kristianhentschel/REDEUCE/hardware/prototype/trivial-double/Readme.md

# Components placement

Switch and LED 'front', connected on back copper layer.

Resistor and Connector 'back', connected on front copper layer (one resistor leg on back copper).

# Design Rules

- Minimum Hole diameter 1.0 (default)
- Via Dia 1.5 - Via Drill 1.0
- Minimum track width 0.5
- Clearance 0.4

## Previous version, as produced 
- Minimum Hole diameter 0.3 (default)
- Via Dia 0.6 - Via Drill 0.3
- Minimum track width 0.4
- Clearance 0.4
