kristianhentschel/REDEUCE/PotentialExhibitionDisplay.odt

Glasgow University REDEUCE

# Significance of the DEUCE

In the mid 1950s, the company English Electric introduced the DEUCE computer, a commercially available version of the Pilot ACE, which was based on Alan Turing's original Automatic Computing Engine. Between 1955 and 1964, 31 DEUCE machines were sold around the world. Mostly used by Universities in the UK, the DEUCE was one of the first big steps towards the use of high speed computing in research.

Alan Turing's vision had a great emphasis on the speed at which calculations could be done. Due to the DEUCE being modelled after Turing's original ideas, the DEUCE ran programs in a way that made it the fastest commercial computer available for many decades after it was first released.

# History of the DEUCE at the University of Glasgow

The English Electric DEUCE was the University of Glasgow's very first computer, installed in the Chemistry building in 1959, on the condition that other universities and industries would be allowed to use it for research purposes as well. For the new few years, Universities all over Scotland, mainly Chemistry departments, would use the DEUCE to cut down significantly on time spent on calculations, increasing the overall productivity of research by impressive margins. The University's DEUCE was eventually replaced by the KDF-9, installed in March 1964.

# How Our Model Compares

### Display

The original DEUCE had 2 CRT displays, one displaying the contents of a selected Delay Line, the other display the contents of the Single, Quadruple, and Double Register stores.

Our model has the same arrangement for the display, but doesn't use CRT tubes, instead just opting for a (tablet?) with the memory contents displayed in a similar fashion to the original.

### Materials

The DEUCE's memory was made of Mercury Delay Lines, and a large magnetic store drum to hold extra words.

Our model instead just emulates memory and the processor through a Raspberry Pi, encased inside of our Console and displaying the outputs on the Console lights as well as the Display screen.

### Functionality

The REDEUCE, as it is now, does not have some of the functionality of the original machine. Storage in the Magnetic Drum has no corresponding emulation, and some functions such as the Multiplier/Divider units were not implemented during the project. The REDEUCE can, and does, read in programs written in (historically accurate?) DEUCE machine language, given that the program uses mostly basic arithmetic and memory transfers.

# Interacting With the Model

The REDEUCE works by getting an example program read into the machine, pressing the “Initial Input” key so the program gets stored into memory, and then the program can be stepped through at the control of the user by using the console. As the program progresses, the user should be able to see changes happening on the display. The User can also set up “Request Stops” by setting the NIS, Source, and Destination words on the Console, so that the program stops when certain instructions are reached.

# Read More

More about the DEUCE, including manuals for both the use of and programming for the machine can be found here:

http://users.tpg.com.au/eedeuce/
