kristianhentschel/REDEUCE/ProjectStatus.odt

Glasgow University Internship Project: REDEUCE

# Model Requirements:

- Ability to read in a file of a correctly written DEUCE program, and execute said program based on user inputs

- User should be able to manipulate states in the machine, such as if it should stop during certain instructions via REQUEST_STOP functionality

- User should be able to step through a program manually, seeing the changing states along the way

- User should also be able to step through a large portion of a program at once

More complex interactions with the above are unlikely, as the learning curve with the system is very steep. Writing ones own programs, or very intricate running of programs which take in multiple sets of cards, is only possible with quite a lot of experience with the machine.

Because of this steep learning curve, combined with the fact that there was very little true interaction even with the original machine, the variety in interaction with our model of the machine is quite small. However, making it much more versatile would be staying less true to the actual machine.

# Current State of Emulator:

- Currently a large Java-based Emulator which provides a text-based IO which can write to files and step through programs according to user input.

- On top of this, there is also a Parser which should be able to receive input and send output in a way that a simple interface ought to be able to manipulate. The outputs could be translated into signals which manipulate the state of lights, for example. And inputs to the parser could be written with fairly simple translations.

- squaresProgram.txt is a historically-correctly written program which prints out perfect squares, such as 1,4,9,16,etc until the maximum value that can be represented in a 32-bit word. The emulator executes this program perfectly, as can be seen via the Console class, given the correct inputs.

- Highly Object Oriented! Only very large classes are the Processor and the Parser, as they have a lot of logic involved in their usage.

- Basic STOPs and the like are implemented with the User Interface. Given the right state, a user ought to be able to “catch” the program during certain instructions and so on.

# Shortcomings of Current Emulator:

- Only uses the “high speed store,” not implementing any of the functionality of the magnetic drum for extra storage.

- Currently throws an error every time every “card” in a program has been read into the machine. It does not impact execution of the program, and should be able to be worked around fairly easily. Due to time constraints however, I was hesitant to refactor all of the necessary code and leave the project non-functional.

- Has NOT implemented the Multiplier/Divider units of the original machine. It was agreed upon members working on the project that much more basic programs should be prioritised for the purposes of this project.

- Has not implemented the TCA/TCB states of the machine which are meant to manipulate how words are read in and manipulated when their respective states are active. Again, due to time-constraints and a potential misunderstanding of their functionality, which made the prospect of implementation very risky.

- As it is now, it might be that manipulating the switches on the console is not possible while it is executing a program, which was presumably possible on the original machine. More threads might make this possible, but that level of refactoring was not possible given the time left in the project when this was considered. Potentially doesn't affect our original intention on how a user would interact with the device in any case, however.

- Due to uncertainty in understanding of program's execution on the machine, programs which take in large amounts of data, or read in data multiple times, were not considered in this emulator's implementation.

# Recommended Reading:

- http://users.tpg.com.au/eedeuce/ldmpart1.html#index

- http://users.tpg.com.au/eedeuce/pm.htm#ch5

- http://members.iinet.net.au/~dgreen/deuce/mud21.html

- http://members.iinet.net.au/~dgreen/deuce/extract.html#mud19

- http://www.fcet.staffs.ac.uk/jdw1/sucfm/eedeuce/pjwalker.htm

These, along with a trip to the University Archives, made up a majority of the reading done in preparation for the emulation of the machine. Other sources were read and other people consulted for advice on what makes a good technology exhibit, etc.

# Advice for DEUCE Programming:

- Instructions are stored in Delay Lines, so as you are writing your program, make sure you're keeping track of which microcycle you would be in at the time of that line's execution. If you find yourself looping past 32, make sure you're either intentionally forming a loop, or make sure the instructions get written into a new Delay Line AND that the NIS for the last instruction leads to this new delay line.

- Most instructions will take 2 microcycles. So for very basic programs, it is probably best to just have every other line be an empty line. Also gives space if you want to exit a loop, as loops are exited by a DISCRIM instruction adding an extra microcycle before fetching the next instruction.

- Most easily written in a “higher level” form, such as “27-13” rather than a long string of 1s and 0s.

- Remember DEUCE words were represented in “backwards” binary!

- Keep a list of the different types of instructions nearby, some are very unintuitive.

- Re-read the recommended reading. Multiple times.

- First 4 lines of each Triad should be the same other than the Delay Line which they're instructing the machine the write the Words to.

# Future Development:

- Errors need refactoring

- Number of outputs probably needs changing depending on loops. Perhaps when there's a loop, such as when a user wants a program to run on its own, the number of outputs should be contiually added inside of the loop itself so if there is a STOP (such as when the STOPKEY is UP), then there aren't extra outputs waiting in the pipeline to be outputted.

- Potential multi-threading for different potential user inputs while execution is being carried out; assuring the appropriate responses are given at appropriate times.

- Multiple User Interfaces. Web-based app? Hardware Implementation?

- Multiply/Divide units should be implemented

- Multiple subroutines should be written, along with more example programs

- Implement behaviour of different states. TCA/TCB, forced DISCRIM, etc.

- Make sure messages sent from the Parser are received and manipulated as they should be. Strings split and converted into a DL display, for example.

# Running the Emulator:

To run the squaresProgram.txt file, one must just:

- Run the ParsedConsole class' main method

- Input “LOAD_CARDS squaresProgram.txt”

- Input “INIT_IN”

- Input “ONE_SHOT_UP”, or “ONE_SHOT_DOWN”, or “ONE_SHOT_DIAL (1-10)”, or “RUN”

- There should be outputs from here.

- “START_PUNCH” opens a file called cardsPunched.txt, which gets values written into it each time a punch instruction is executed.

- “CLEAR STORE” erases everything in memory.

- “OFF” turns off the machine.

- “EXTTREE (setting)” changes the setting to, for example, REQUEST_STOP.

Other commands can be executed, but the above is a very basic example of our intended interactivity.
