kristianhentschel/REDEUCE/hardware/plans/deuce-parts-costs.xlsx

Date | Supplier | Description | Total inc. VAT and Shipping
2016-07-25 | DigiKey | Prototype Components | 68.64
2016-07-29 | Rapid | PCB milling copper clad boards | 22.55
2016-08-11 | Flux Laser Studio | Laser Cutting inc. Materials | 51.6
2016-08-26 | Manchester Uni Library | Deuce control panel document scans | 36
2016-08-12 | DigiKey | switches and other components | 244.14
2016-08-12 | RS | cables and other components | 31.67
2016-08-12 | CoolComponents | printer | 56.67
2016-08-12 | Amazon | pi, power supplies, hardware, screen | 102.45
2016-08-19 | Ragworm/Stickleback | PCB production | 247.97
