kristianhentschel/REDEUCE/hardware/plans/v1_bom.xlsx

Sheet: Sheet1
Quantity | Part | Supplier | Supplier Part Number | Unit Price ex VAT | Unit Price inc VAT | Previously bought | Comment | Extended Price inc VAT | Still to order
1 | Raspberry Pi 3 | amazon | http://www.amazon.co.uk/dp/B01CCOXV34 |  | 30.7 | 0 |  | 30.7 | 1
1 | Aukru Micro USB Power Supply 5V 2000mA | amazon | https://www.amazon.co.uk/Aukru-Supply-Charger-Raspberry-Banana/dp/B017YW26YE |  | 4.99 | 0 | 2A Power supply for raspberry pi | 4.99 | 1
1 | waveshare 7 inch LCD(C) 1024x600 Rev 2.1 | amazon | https://www.amazon.co.uk/Waveshare-Capacitive-Interface-Raspberry-Beaglebone/dp/B015E8EDYQ |  | 45.99 | 0 | 7 inch HDMI display with mounting holes, could alternatively get a full size mnonitor | 45.99 | 1
1 | SanDisk Extreme 16 GB microSDHC Class 10 | amazon | https://www.amazon.co.uk/SanDisk-Extreme-microSDHC-Frustration-Packaging/dp/B013P1M49A |  | 10.47 | 0 | sd card for raspberry pi | 10.47 | 1
1 | M3 x 20mm bolts | amazon | http://www.amazon.co.uk/dp/B015A38FUS |  | 7.07 | 0 |  | 7.07 | 1
1 | M3 hex nuts | amazon | http://www.amazon.co.uk/dp/B00GYS1SXU |  | 3.23 | 0 |  | 3.23 | 1
1 | Thermal printer | coolcomponents | 695 | 37.92 | 45.504 | 0 | card punch! | 45.504 | 1
2 | Thermal printer paper 34ft | coolcomponents | 696 | 1.63 | 1.956 | 0 |  | 3.912 | 2
40 | SWITCH TOGGLE SPDT 5A 120V | DIGIKEY | EG2352-ND | 1.514 | 1.8168 | 1 | on-off | 72.672 | 39
50 | SWITCH TOGGLE SPDT 5A 120V | DIGIKEY | EG2389-ND | 1.764 | 2.1168 | 1 | mom-off-mom | 105.84 | 49
5 | SWITCH TOGGLE SPDT 5A 120V | DIGIKEY | EG2394-ND | 2.14 | 2.568 | 4 | mom-off-on | 12.84 | 1
0 | SWITCH TOGGLE SPDT 5A 120V | DIGIKEY | EG2377-ND | 1.62 | 1.944 | 4 | on-off-on | 0 | 0
12 | IO EXPANDER I2C 16B 28SDIP | DIGIKEY | MCP23017-E/SP-ND | 0.9 | 1.08 | 2 | one per 8 double/16 single switches | 12.96 | 10
2 | IC DRVR DSPLAY LED 8DIG 24-DIP | DIGIKEY | MAX7221CNG+-ND | 6.35 | 7.62 | 2 |  | 15.24 | 0
0 | LED AMBER DIFF 5MM OVAL T/H | DIGIKEY | 1125-1192-ND | 0.2092 | 0.25104 | 100 |  | 0 | 0
2 | CONN IC DIP SOCKET 24POS TIN | DIGIKEY | ED3049-5-ND | 0.19 | 0.228 | 2 |  | 0.456 | 0
12 | CONN IC DIP SOCKET 28POS TIN | DIGIKEY | ED3050-5-ND | 0.235 | 0.282 | 2 |  | 3.384 | 10
0 | AC/DC WALL MOUNT ADAPTER 5V 5W | DIGIKEY | 1470-2764-ND | 4.71 | 5.652 | 1 | Output: 5V 1A, for lights | 0 | 0
2 | CON PWR JCK 2.0 X 6.0MM HIGH CUR | DIGIKEY | CP-050AH-ND | 0.77 | 0.924 | 1 |  | 1.848 | 1
20 | 4POS SIL HORIZONTAL PIN HEADER | DIGIKEY | 952-1965-ND | 0.087 | 0.1044 | 0 | 12 * 4 pins angled, used on switch boards | 2.088 | 20
2 | CONN HEADER 48POS .100" SNGL TIN | DIGIKEY | SAM1035-48-ND | 1.7 | 2.04 | 0 | 12 * 4 pins, used on main board | 4.08 | 2
1 | AC/DC WALL MOUNT ADAPTER 5V 12W | DIGIKEY | 1470-3108-ND | 8.22 | 9.864 | 0 | 2.5A power supply for printer | 9.864 | 1
1 | SWITCH PUSH SPST-NO 3A 120V | DIGIKEY | EG1932-ND | 2.08 | 2.496 | 0 | mc slip button | 2.496 | 1
2 | LED RED DIFF 5MM ROUND T/H | DIGIKEY | 160-1964-ND | 0.31 | 0.372 | 0 | alarum | 0.744 | 2
12 | 4 pin 70cm dupont connector assembled jumper wires female-female | EBAY |  |  | 0.289 | 12 | 4 pin wires for switch rows (already bought by kristian as shipped from china, may take a while to arrive) | 3.468 | 0
1 | one-shot dial tbd | EBAY |  |  | 15 | 0 | old telephone dial | 15 | 1
1 | 3mm laserable plywood 600x600mm | flux laser studio glasgow | material | 5 | 6 | 0 | as per price list. 600x600 base is big enough for front panel and spacers. | 6 | 1
1 | front panel laser cutting service | flux laser studio glasgow | cutting time | 30 | 36 | 0 | £30 minimum charge | 36 | 1
1 | front panel laser cutting service | flux laser studio glasgow | delivery | 8 | 9.6 | 0 |  | 9.6 | 1
1 | main board pcb production 100x100 | ragworm |  |  | 40.3 | 0 | 100x100mm double sided PCB guide price | 40.3 | 1
0 | RVFM Copper Clad Double Sided FR4 Fibre Glass Board 203 X 305mm | RAPID | 34-0845 | 3.7 | 4.44 | 4 | PCB production base material | 0 | 0
16 | RS Pro Right Angle Cable Mount IDC Connector Socket, 10 Way, 2 Row, 2.54mm Pitch | RS | 625-7369 | 0.29 | 0.348 | 0 | 2x10 IDC cable end | 5.568 | 16
16 | Through Hole IDC Connector Plug, 10 Way, 2 Row, 2.54mm Pitch | RS | 625-7252 | 0.23 | 0.276 | 0 | 2x10 IDC pcb end | 4.416 | 16
1 | RS Pro 10 Way Unscreened Flat Ribbon Cable, 12.7 mm Width, 10m | RS | 214-0661 | 13.21 | 15.852 | 0 | 10m ribbon cable for LED connections and switches | 15.852 | 1
10 | 2n7000TA Fairchild (in pack of ten) | RS | 39-0224 | 0.14 | 0.168 | 0 | mosfet for max7221 logic level shifter | 1.68 | 10
1 | Rotary Switch, 16 Way, Through Hole | RS | 655-3235 | 3.46 | 4.152 | 0 | delay line select | 4.152 | 1
1 | Box / Rack for mounting front panel and main board in | TBD |  | 0 | 0 |  | build a wood frame? | 0 | 1

Sheet: Sheet2
Total Cost inc VAT
538.414
