kristianhentschel/REDEUCE/hardware/plans/deuce-interface-plan.pdf

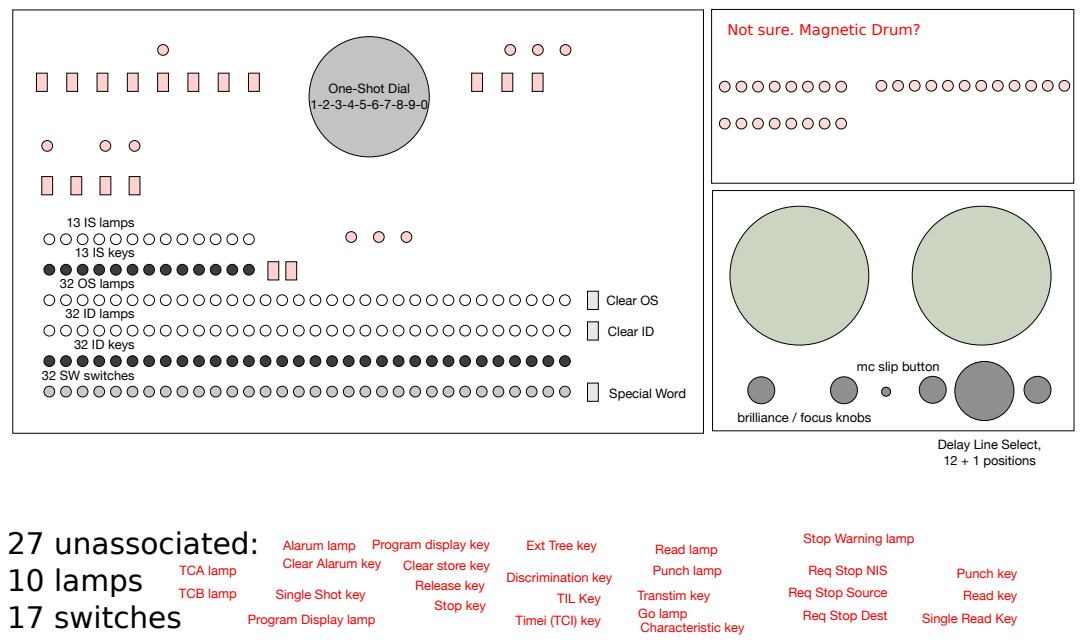
[picture p2: page 1]
13 IS lamps; 13 IS keys; 32 OS lamps; 32 ID lamps; 32 ID keys; 32 SW switches; Clear OS; Special Word; Clear ID; Discrimination key; Punch key; Characteristic key; Punch lamp; Read lamp; Go lamp; TCB lamp; TCA lamp; 27 unassociated: 10 lamps 17 switches

Not sure. Magnetic Drum?

One-Shot Dial

mc slip button

brilliance / focus knobs

Delay Line Select,
12 + 1 positions

Stop Warning lamp Alarum lamp
Clear Alarum key

Program display key
Clear store key
Transtim key Release key

Ext Tree key

Req Stop NIS
Req Stop Source
Req Stop Dest

Stop key Single Shot key
Program Display lamp

Read key
Single Read Key

TIL Key
Timei (TCI) key
