kristianhentschel/REDEUCE/hardware/plans/v1_board_assembly.pdf

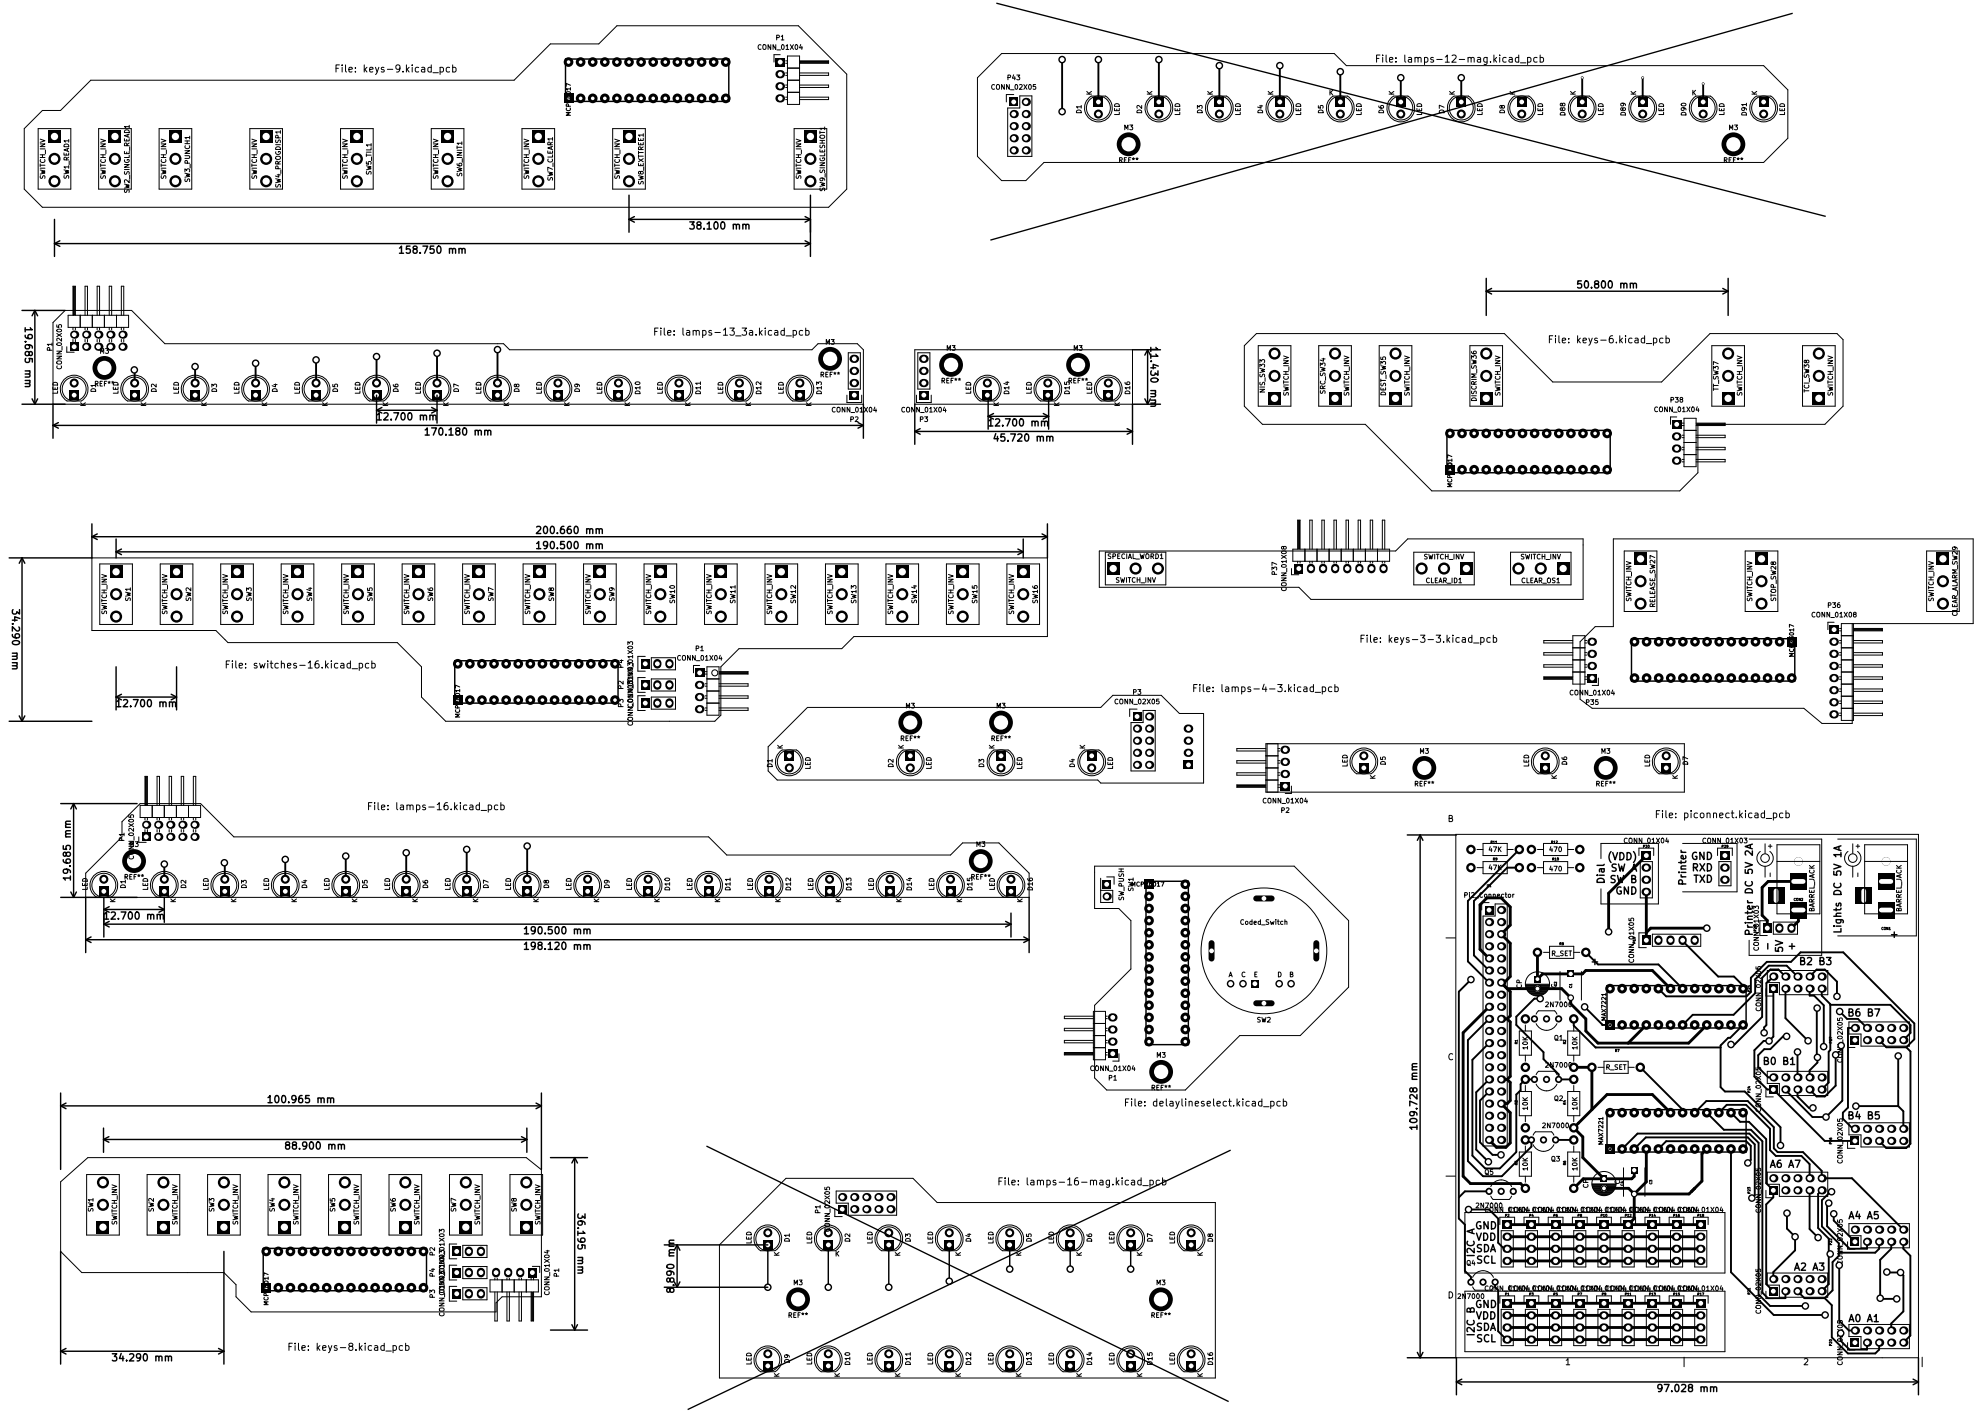
[picture p3: page 1]
