kristianhentschel/REDEUCE/hardware/v1/piconnect-brd.pdf

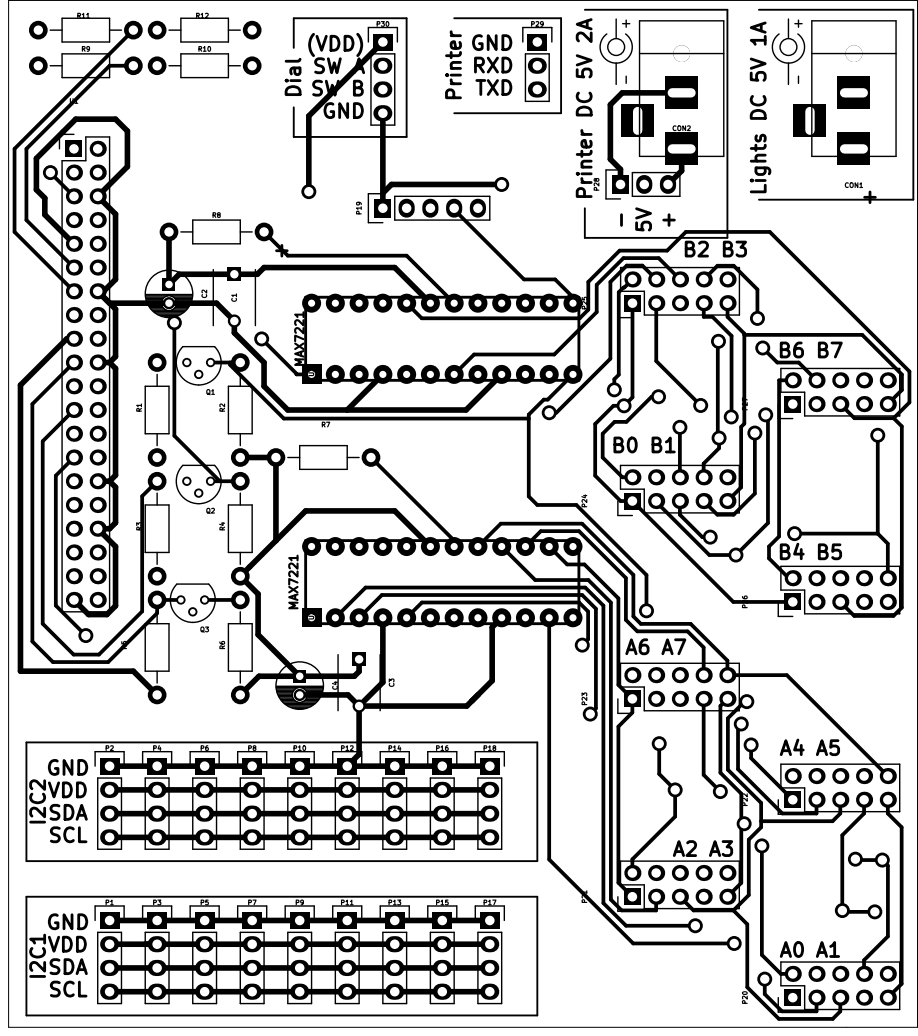
[picture p4: page 1]
