kristianhentschel/REDEUCE/hardware/plans/KristianHentschel_600x600mm_3mmPlywood_deucepanel_2016-08-11_2.pdf

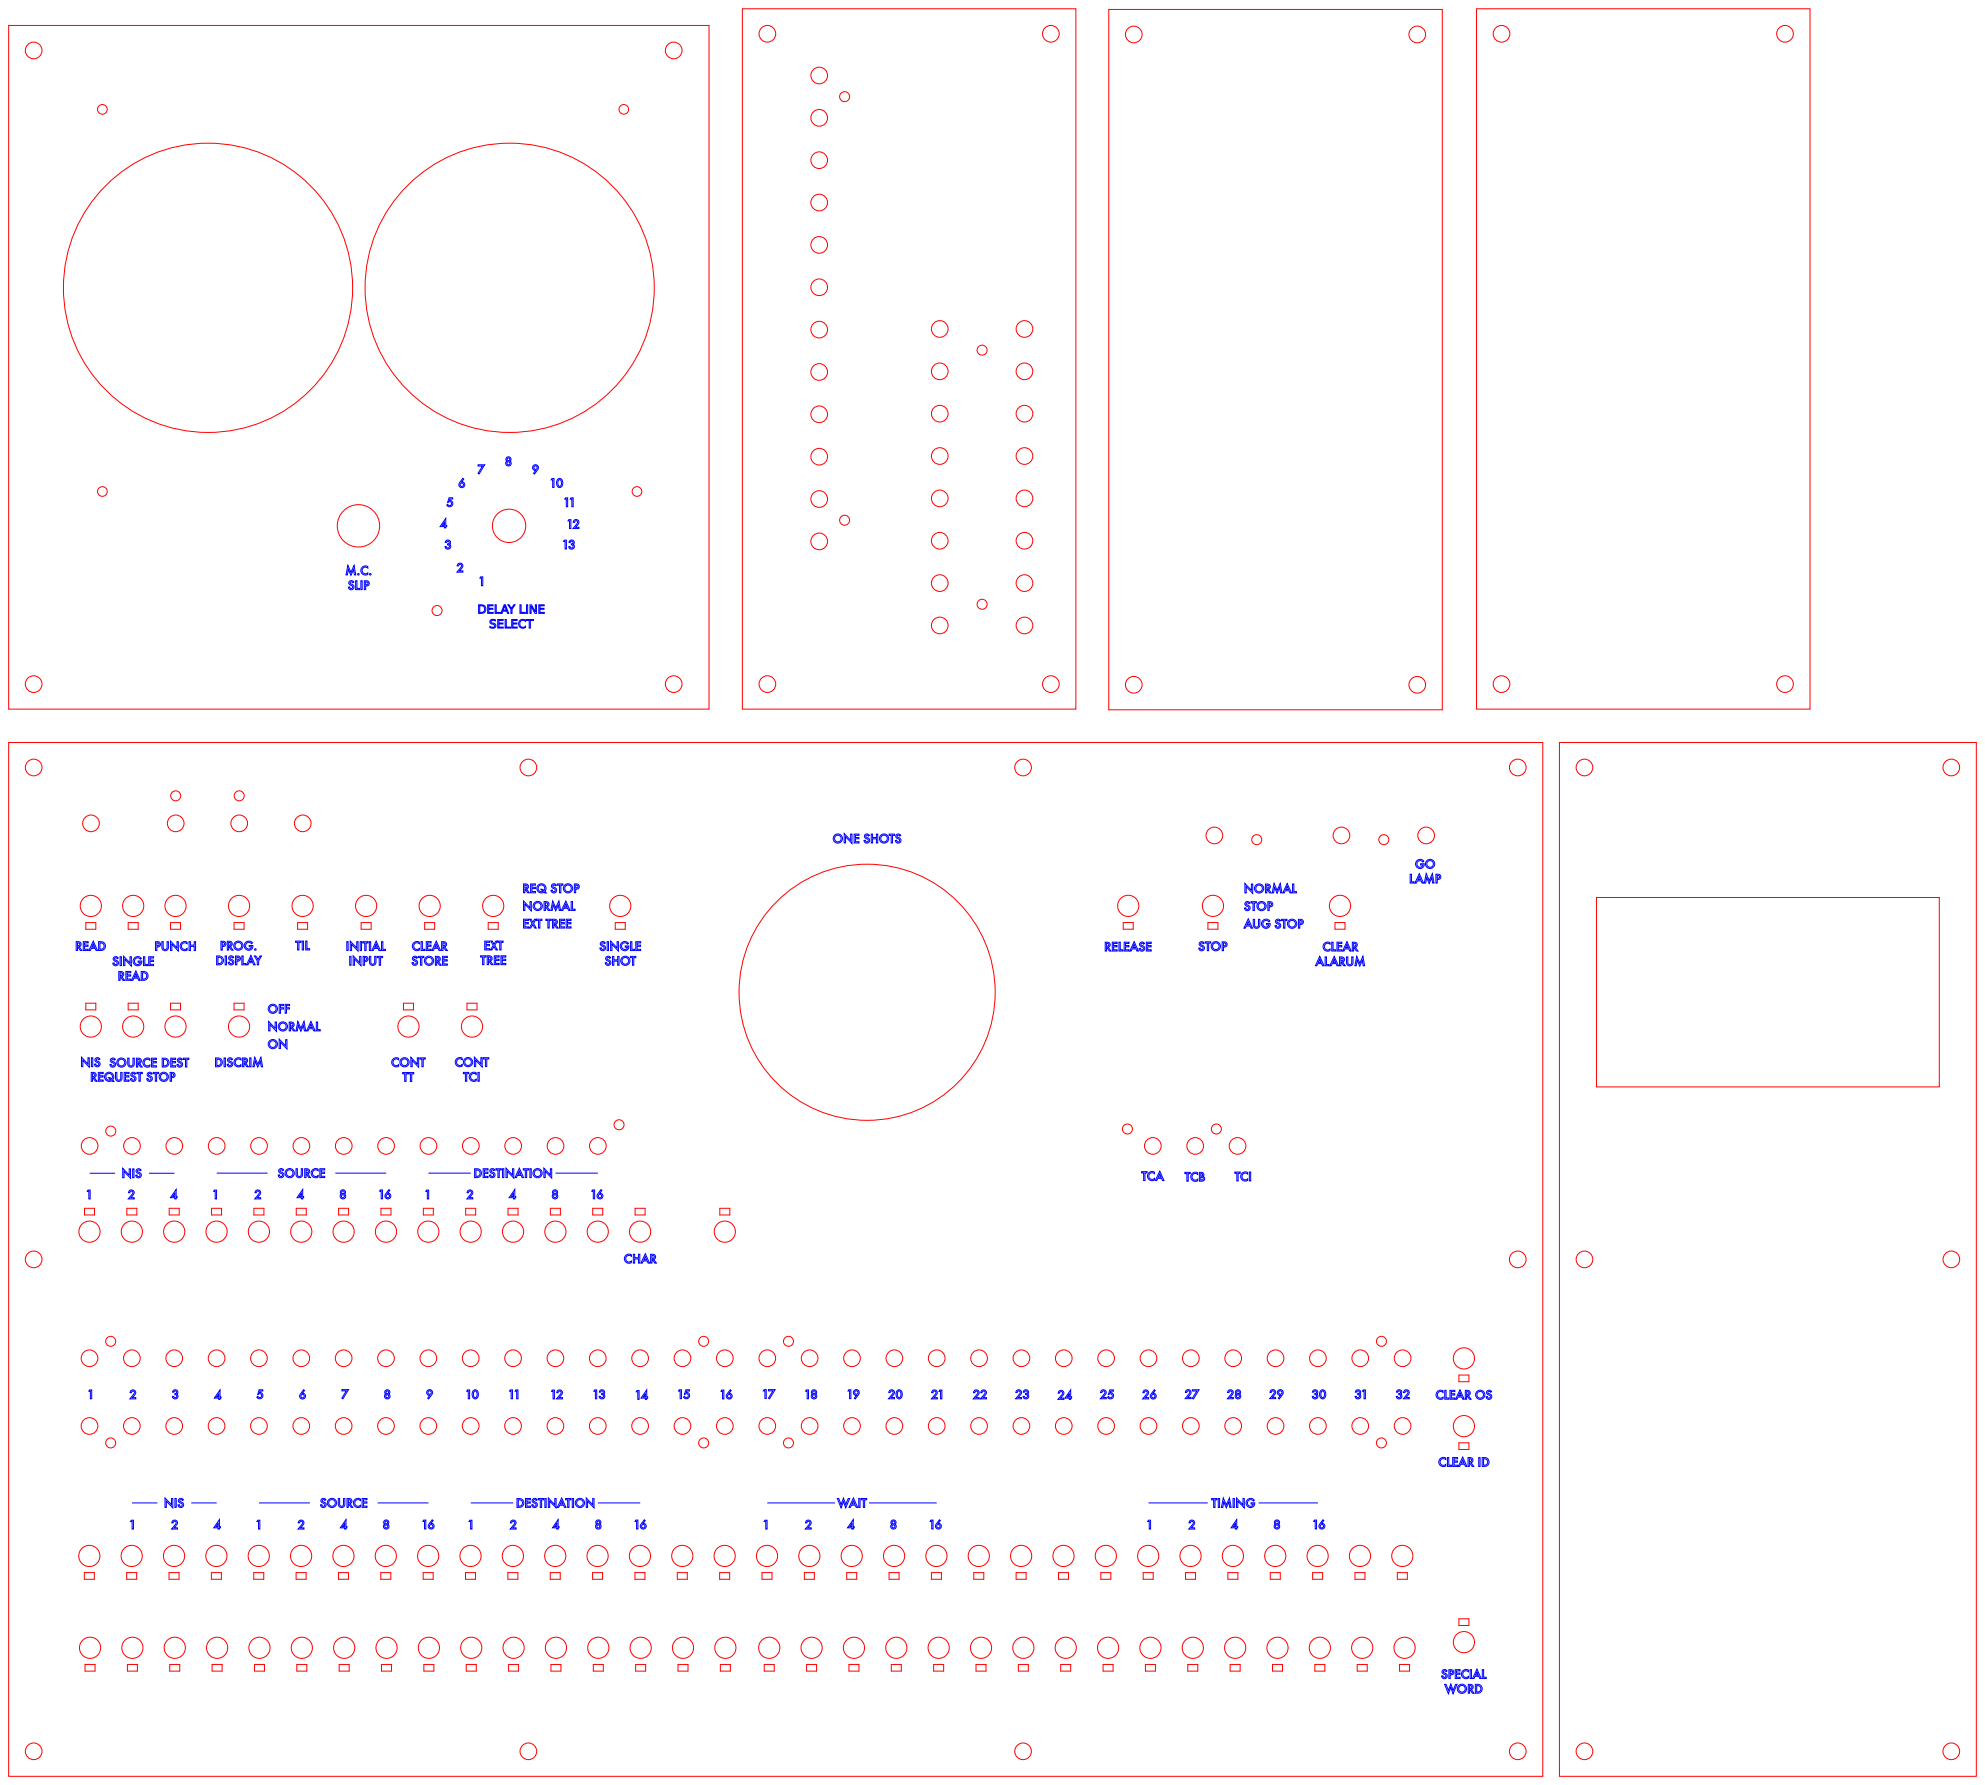
[picture p5: page 1]
