kristianhentschel/REDEUCE/hardware/plans/v1_frontpanel_cut_engrave.pdf

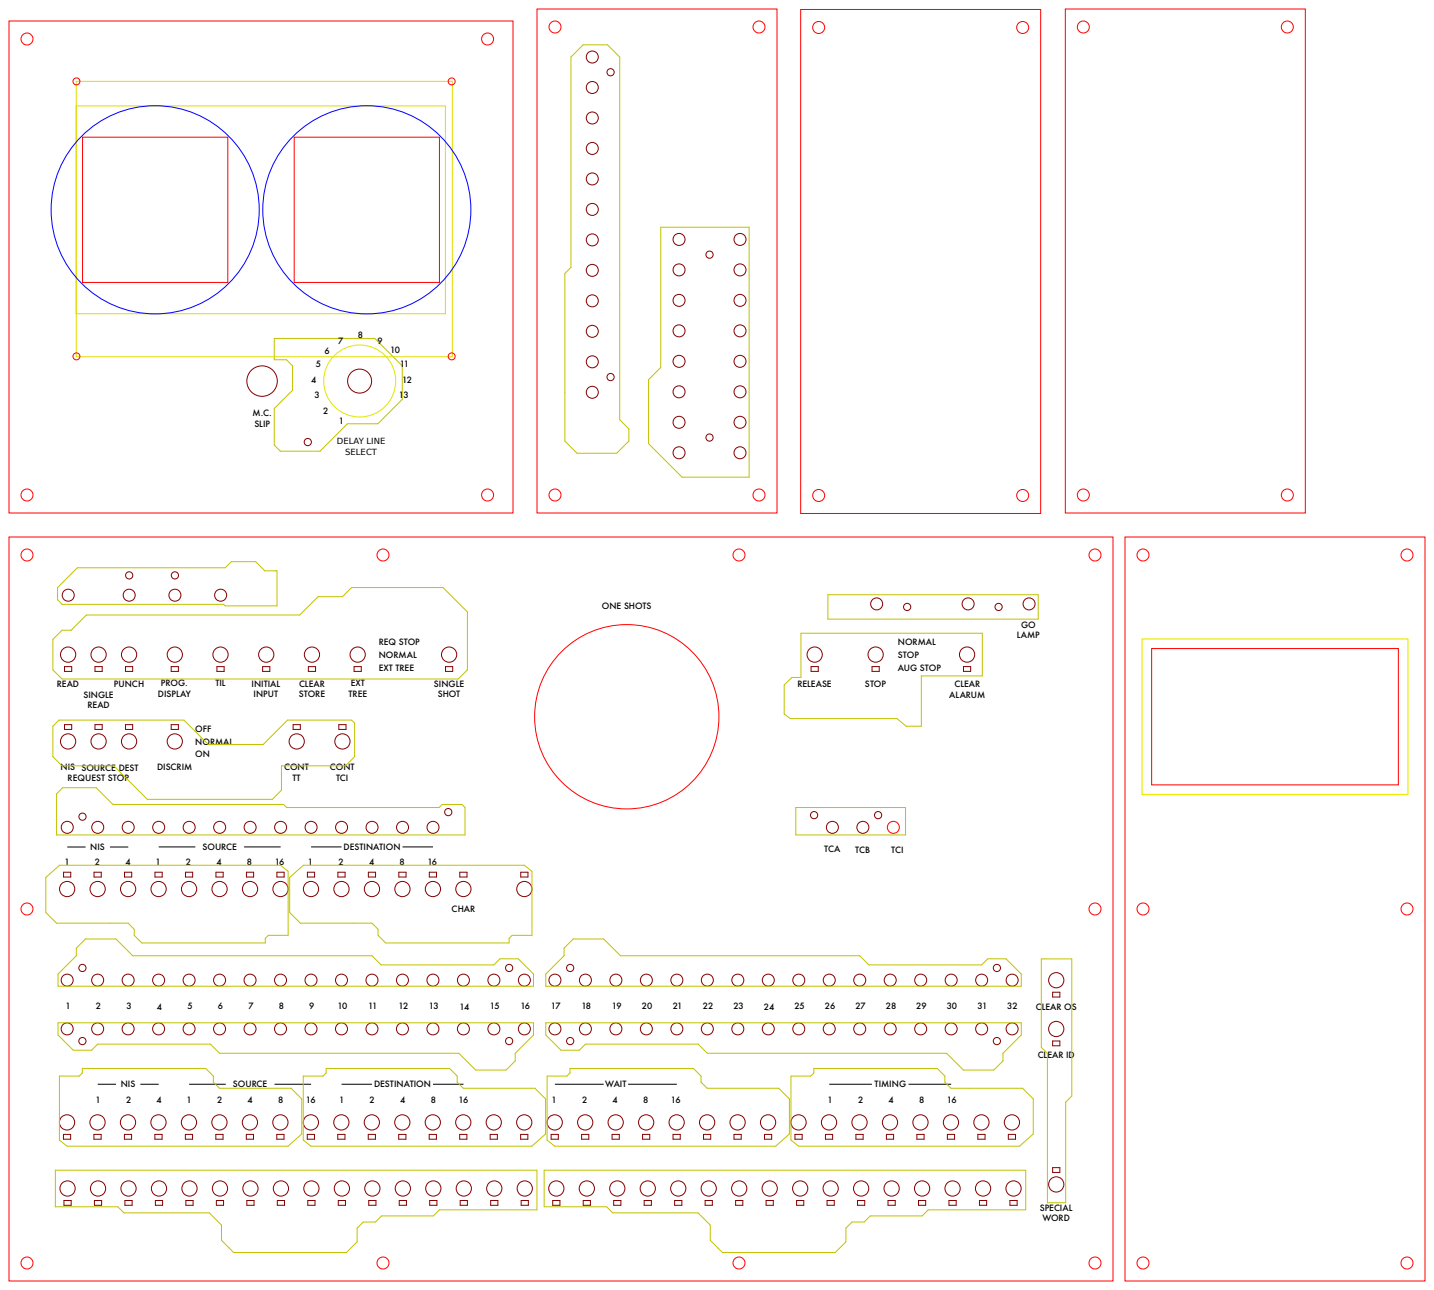
[picture p6: page 1]
M.C. SLIP; DELAY LINE SELECT; NIS; SOURCE; DESTINATION; WAIT; TIMING; CLEAR ALARUM; SPECIAL WORD; CLEAR ID; SINGLE SHOT; CLEAR OS; TIL; CLEAR; STORE; TCI; CONT TT; TCA; TCB; INITIAL INPUT; READ; PUNCH; ONE SHOTS; SINGLE READ; REQ STOP NORMAL EXT TREE; NORMAL STOP AUG STOP; OFF NORMAL ON; GO LAMP; RELEASE; CHAR; PROG. DISPLAY; STOP; DISCRIM; EXT TREE; CONT TCI

NIS SOURCE DEST
REQUEST STOP
