kristianhentschel/REDEUCE/hardware/docs/pushbutton-F030015.pdf

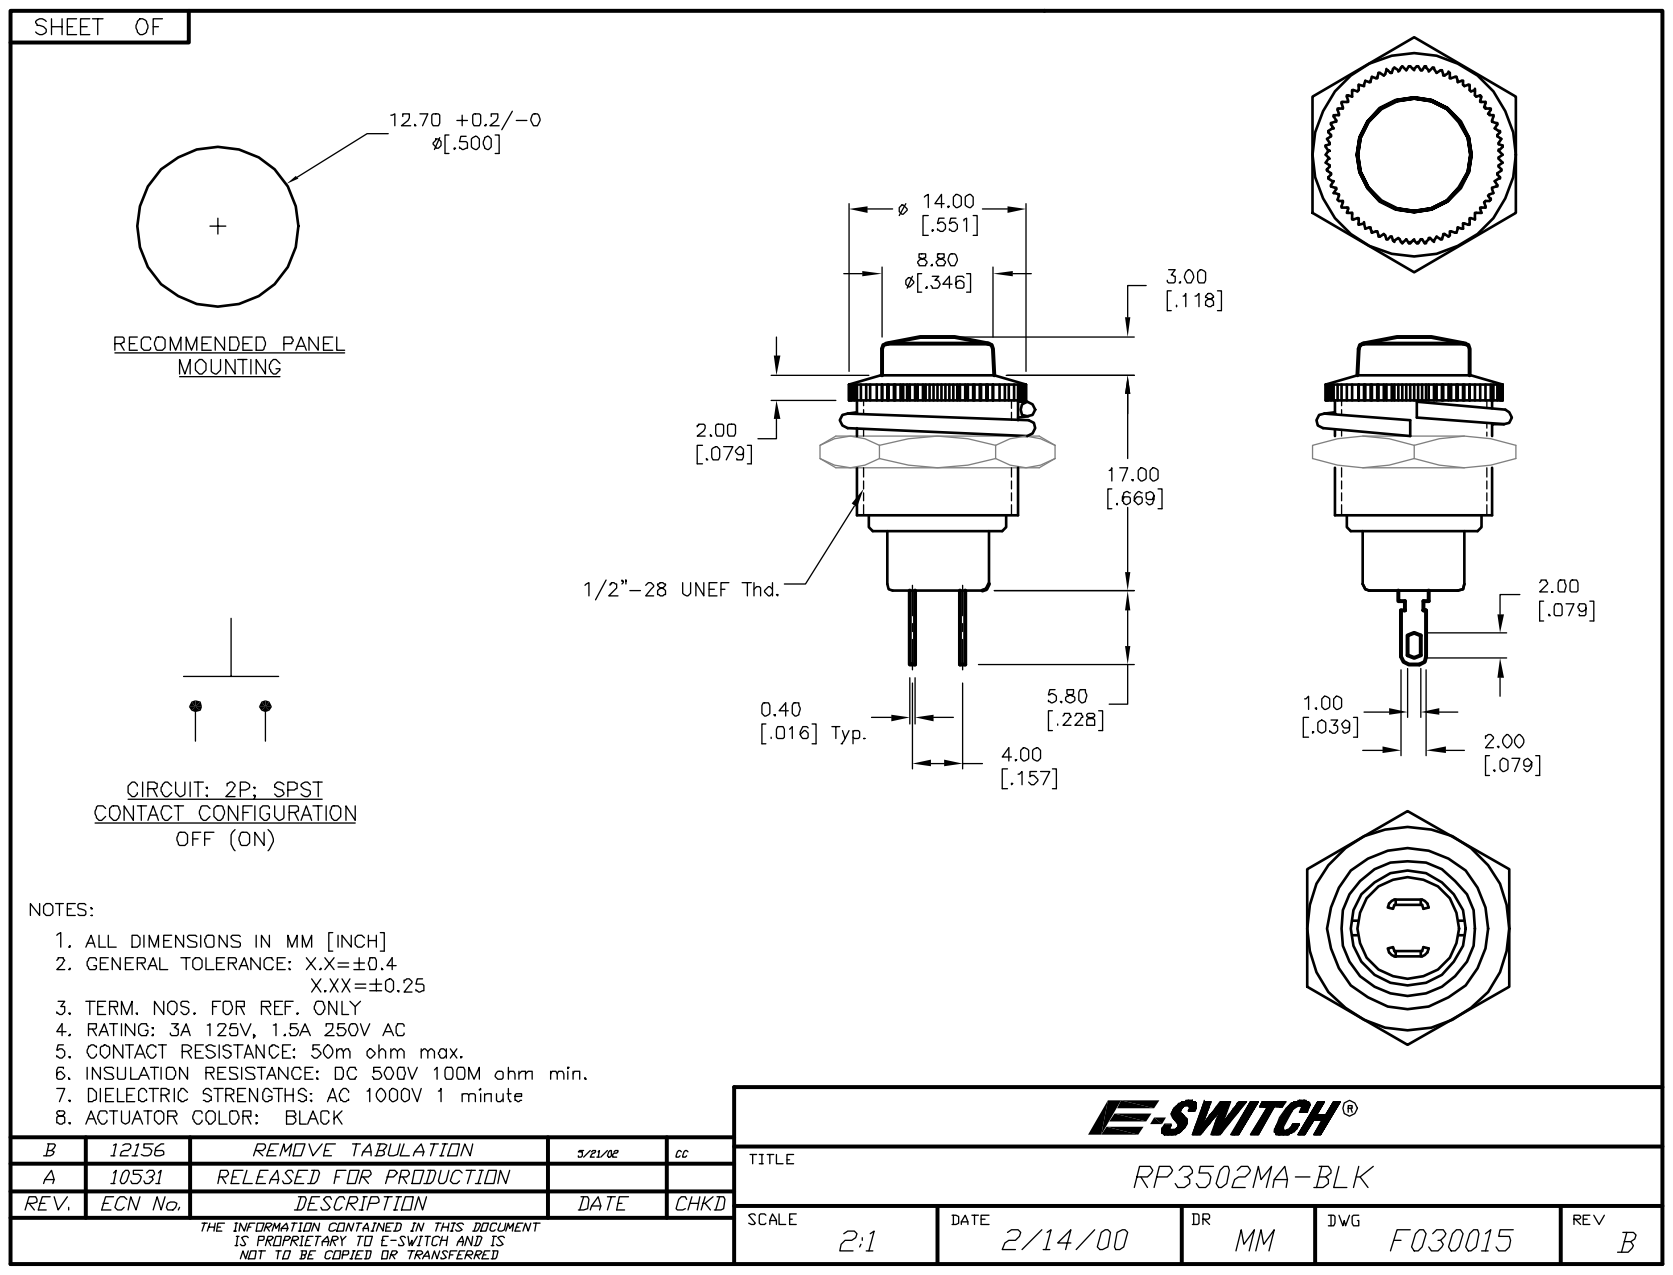
[picture p7: page 1]
