kristianhentschel/REDEUCE/hardware/docs/toggle-switch-ST115003.pdf

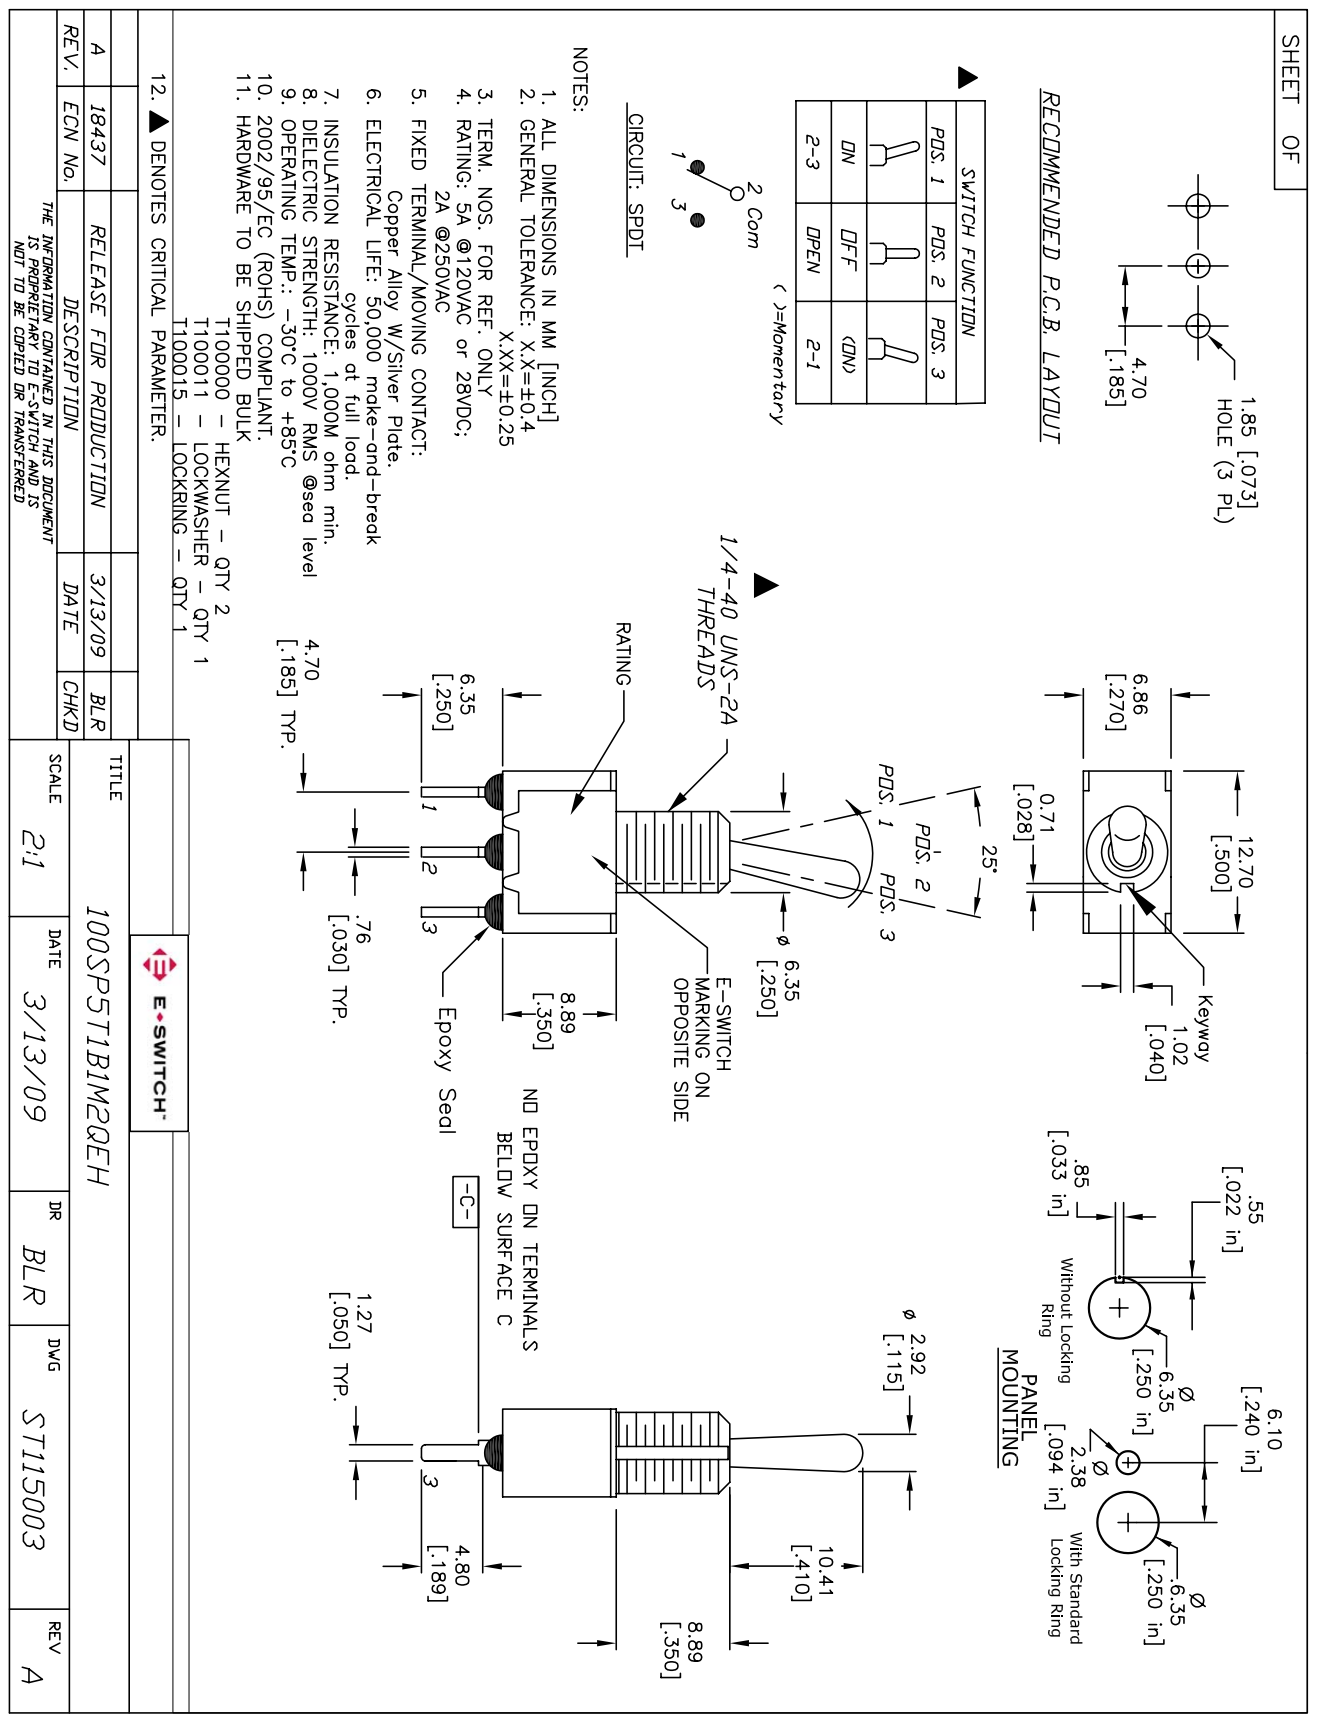
[picture p8: page 1]
