kristianhentschel/REDEUCE/(list of files, drawings)

Other design files:
hardware/prototype/lights/prototype.dsn
hardware/prototype/pi_connect/prototype_pi_connect.dsn
hardware/v1/lamps-16.dsn
hardware/v1/piconnect.dsn
