kristianhentschel/REDEUCE/hardware/v1/keys-9.kicad_pcb

## KiCad design hardware/v1/keys-9.kicad_pcb (2016-09-02)

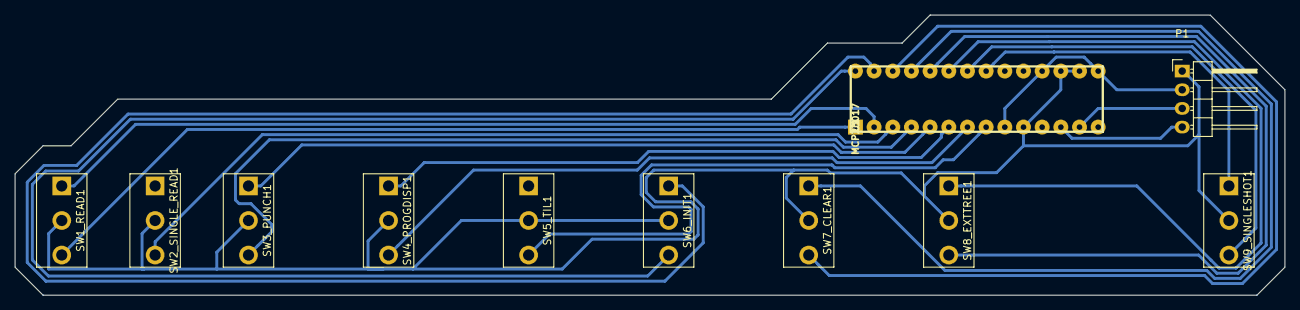
[picture p9: board keys-9.kicad_pcb from above]

Board: 2 copper layers, 172.7 x 38.1 mm, 11 parts (0 on the bottom side), 20 nets.

Parts:
P1: CONN_01X04; Pin_Header_Angled_1x04
SW1_READ1, SW2_SINGLE_READ1, SW3_PUNCH1, SW4_PROGDISP1, SW5_TIL1, SW6_INIT1, SW7_CLEAR1, SW8_EXTTREE1, SW9_SINGLESHOT1: SWITCH_INV; SW_SPDT-custom
U1: MCP23017; DIL28

Connections:
/CLEAR_A: SW7_CLEAR1.3, U1.26
/CLEAR_B: SW7_CLEAR1.1, U1.25
/EXTREE_A: SW8_EXTTREE1.1, U1.23
/EXTREE_B: SW8_EXTTREE1.3, U1.24
/INIT_A: SW6_INIT1.1, U1.27
/INIT_B: SW6_INIT1.3, U1.28
/PROGDISP_A: SW4_PROGDISP1.3, U1.7
/PROGDISP_B: SW4_PROGDISP1.1, U1.6
/PUNCH_A: SW3_PUNCH1.1, U1.5
/PUNCH_B: SW3_PUNCH1.3, U1.4
/READ_A: SW1_READ1.1, U1.2
/READ_B: SW1_READ1.3, U1.1
/SCK: P1.4, U1.12
/SDA: P1.3, U1.13
/SINGLE_A: SW9_SINGLESHOT1.1, U1.21
/SINGLE_B: SW9_SINGLESHOT1.3, U1.22
/SREAD_DOWN: SW2_SINGLE_READ1.3, U1.3
/TIL_DOWN: SW5_TIL1.3, U1.8
GND: P1.1, SW1_READ1.2, SW2_SINGLE_READ1.2, SW3_PUNCH1.2, SW4_PROGDISP1.2, SW5_TIL1.2, SW6_INIT1.2, SW7_CLEAR1.2, SW8_EXTTREE1.2, SW9_SINGLESHOT1.2, U1.10, U1.16, U1.17
VDD: P1.2, U1.9, U1.15, U1.18
