kristianhentschel/REDEUCE/hardware/v1/lamps-16-mag.kicad_pcb

## KiCad design hardware/v1/lamps-16-mag.kicad_pcb (2016-09-02)

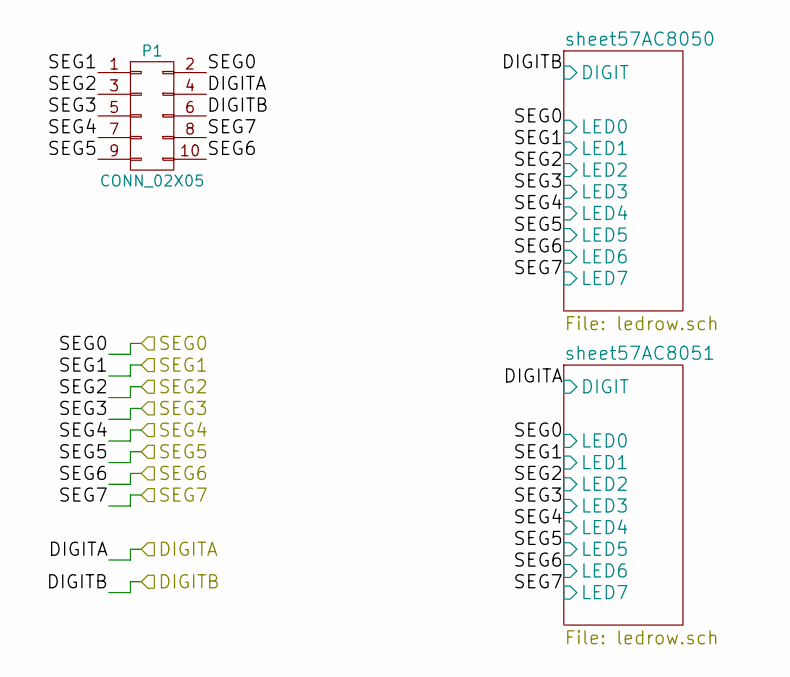
[picture p10: schematic lamps-16-mag.sch]

Parts:
P1: CONN_02X05; Pin_Header_Straight_2x05

Connections:
/DIGITA: P1.4; also elsewhere on the board
/DIGITB: P1.6; also elsewhere on the board
/SEG0: P1.2; also elsewhere on the board
/SEG1: P1.1; also elsewhere on the board
/SEG2: P1.3; also elsewhere on the board
/SEG3: P1.5; also elsewhere on the board
/SEG4: P1.7; also elsewhere on the board
/SEG5: P1.9; also elsewhere on the board
/SEG6: P1.10; also elsewhere on the board
/SEG7: P1.8; also elsewhere on the board

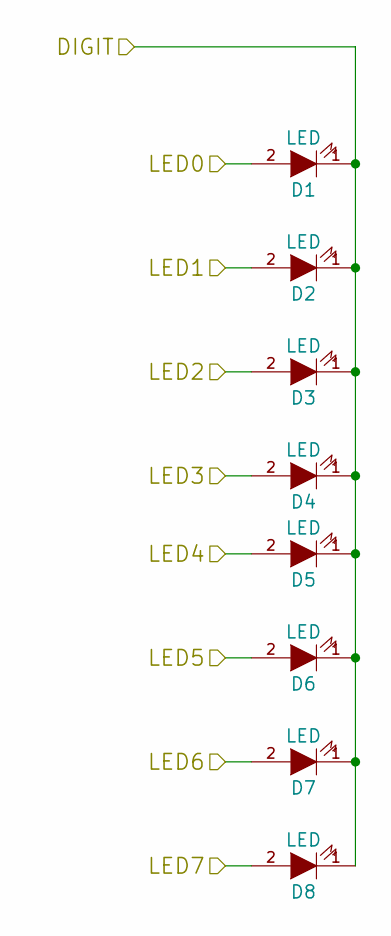
[picture p11: schematic ledrow.sch]

Parts:
D1, D2, D3, D4, D5, D6, D7, D8: LED; LED-5MM-custom

Connections:
/DIGITB: D1.1 (K), D2.1 (K), D3.1 (K), D4.1 (K), D5.1 (K), D6.1 (K), D7.1 (K), D8.1 (K); also elsewhere on the board
/SEG0: D1.2 (A); also elsewhere on the board
/SEG1: D2.2 (A); also elsewhere on the board
/SEG2: D3.2 (A); also elsewhere on the board
/SEG3: D4.2 (A); also elsewhere on the board
/SEG4: D5.2 (A); also elsewhere on the board
/SEG5: D6.2 (A); also elsewhere on the board
/SEG6: D7.2 (A); also elsewhere on the board
/SEG7: D8.2 (A); also elsewhere on the board

Parts of its further copies:
D9, D10, D11, D12, D13, D14, D15, D16: LED; LED-5MM-custom

Connections of its further copies:
/DIGITA: D9.1 (K), D10.1 (K), D11.1 (K), D12.1 (K), D13.1 (K), D14.1 (K), D15.1 (K), D16.1 (K); also elsewhere on the board
/SEG0: D9.2 (A); also elsewhere on the board
/SEG1: D10.2 (A); also elsewhere on the board
/SEG2: D11.2 (A); also elsewhere on the board
/SEG3: D12.2 (A); also elsewhere on the board
/SEG4: D13.2 (A); also elsewhere on the board
/SEG5: D14.2 (A); also elsewhere on the board
/SEG6: D15.2 (A); also elsewhere on the board
/SEG7: D16.2 (A); also elsewhere on the board

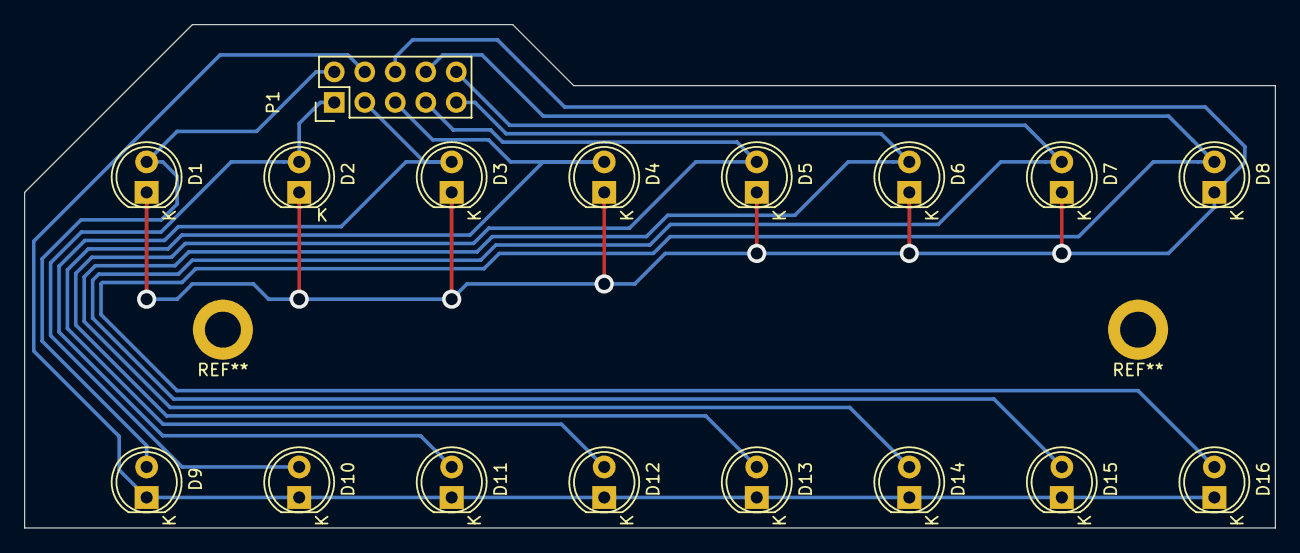
[picture p12: board lamps-16-mag.kicad_pcb from above]

Board: 2 copper layers, 104.1 x 41.9 mm, 17 parts (0 on the bottom side), 10 nets.
