kristianhentschel/REDEUCE/hardware/v1/keys-3-3.kicad_pcb

## KiCad design hardware/v1/keys-3-3.kicad_pcb (2016-09-02)

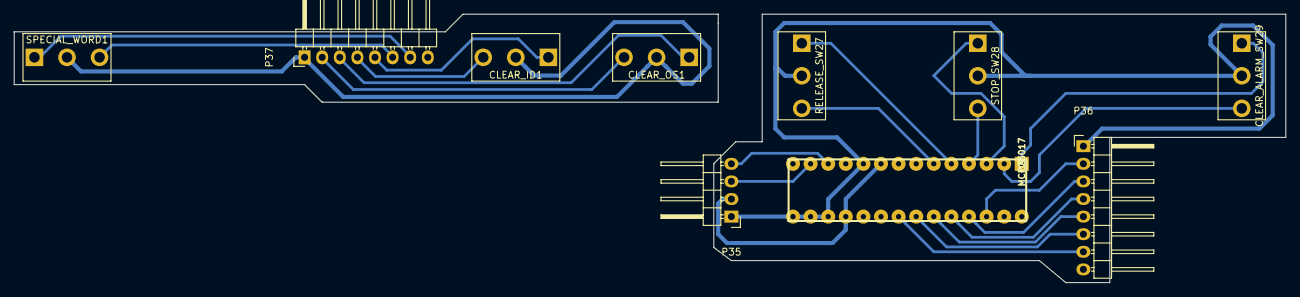
[picture p13: board keys-3-3.kicad_pcb from above]

Board: 2 copper layers, 183.5 x 38.7 mm, 10 parts (0 on the bottom side), 23 nets.

Parts:
CLEAR_ALARM_SW29: SWITCH_INV; SW_SPDT-custom
CLEAR_ID1: SWITCH_INV; SW_SPDT-custom
CLEAR_OS1: SWITCH_INV; SW_SPDT-custom
P35: CONN_01X04; Pin_Header_Angled_1x04
P36, P37: CONN_01X08; Pin_Header_Angled_1x08
RELEASE_SW27: SWITCH_INV; SW_SPDT-custom
SPECIAL_WORD1: SWITCH_INV; SW_SPDT-custom
STOP_SW28: SWITCH_INV; SW_SPDT-custom
U9: MCP23017; DIL28

Connections:
/CLEAR_ID_A: P36.5, U9.23
/CLEAR_ID_B: P36.4, U9.24
/CLEAR_OS_A: P36.3, U9.25
/CLEAR_OS_B: P36.2, U9.26
/SCK: P35.4, U9.12
/SDA: P35.3, U9.13
/SPECIAL_A: P36.7, U9.21
/SPECIAL_B: P36.6, U9.22
GND: CLEAR_ALARM_SW29.2, P35.1, P36.1, RELEASE_SW27.2, STOP_SW28.2, U9.10, U9.15, U9.16, U9.17
unnamed: CLEAR_ALARM_SW29.1, U9.1
unnamed: CLEAR_ALARM_SW29.3, U9.2
unnamed: CLEAR_ID1.1, P37.5
unnamed: CLEAR_ID1.2, CLEAR_OS1.2, P37.1, SPECIAL_WORD1.2
unnamed: CLEAR_ID1.3, P37.4
unnamed: CLEAR_OS1.1, P37.3
unnamed: CLEAR_OS1.3, P37.2
unnamed: P37.6, SPECIAL_WORD1.3
unnamed: P37.7, SPECIAL_WORD1.1
unnamed: RELEASE_SW27.1, U9.5
unnamed: RELEASE_SW27.3, U9.6
unnamed: STOP_SW28.1, U9.3
unnamed: STOP_SW28.3, U9.4
VDD: P35.2, U9.9, U9.18
