kristianhentschel/REDEUCE/hardware/v1/keys-8.kicad_pcb

## KiCad design hardware/v1/keys-8.kicad_pcb (2016-09-02)

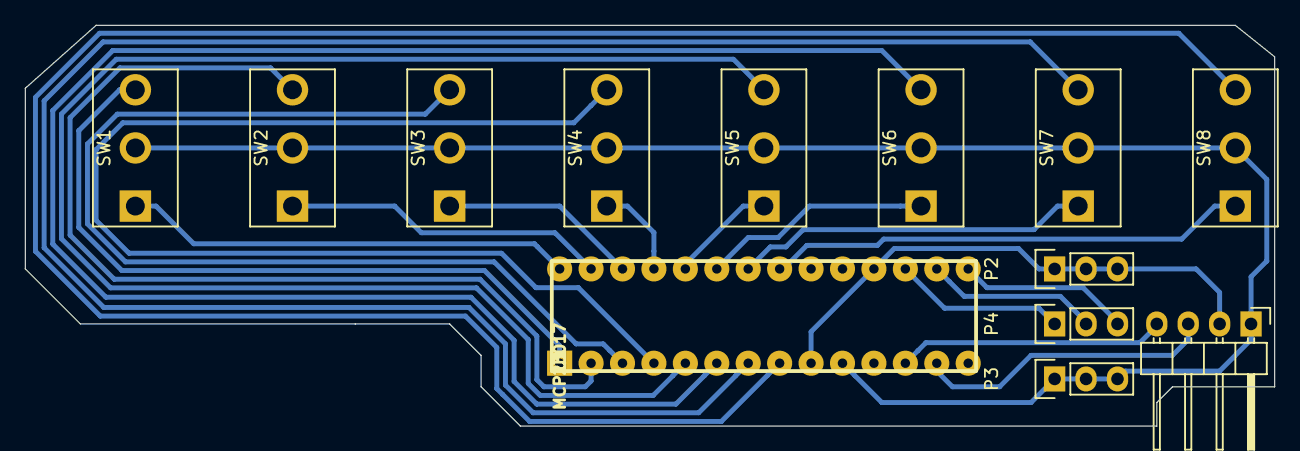
[picture p14: board keys-8.kicad_pcb from above]

Board: 2 copper layers, 101.0 x 32.4 mm, 13 parts (0 on the bottom side), 23 nets.

Parts:
P1: CONN_01X04; Pin_Header_Angled_1x04
P2, P3, P4: CONN_01X03; Pin_Header_Straight_1x03
SW1, SW2, SW3, SW4, SW5, SW6, SW7, SW8: SWITCH_INV; SW_SPDT-custom
U1: MCP23017; DIL28

Connections:
/SCK: P1.4, U1.12
/SDA: P1.3, U1.13
GND: P1.1, P3.1, P3.2, P3.3, SW1.2, SW2.2, SW3.2, SW4.2, SW5.2, SW6.2, SW7.2, SW8.2, U1.10
unnamed: P4.1, U1.17
unnamed: P4.2, U1.16
unnamed: P4.3, U1.15
unnamed: SW1.1, U1.28
unnamed: SW1.3, U1.1
unnamed: SW2.1, U1.27
unnamed: SW2.3, U1.2
unnamed: SW3.1, U1.26
unnamed: SW3.3, U1.3
unnamed: SW4.1, U1.25
unnamed: SW4.3, U1.4
unnamed: SW5.1, U1.24
unnamed: SW5.3, U1.5
unnamed: SW6.1, U1.23
unnamed: SW6.3, U1.6
unnamed: SW7.1, U1.22
unnamed: SW7.3, U1.7
unnamed: SW8.1, U1.21
unnamed: SW8.3, U1.8
VDD: P1.2, P2.1, P2.2, P2.3, U1.9, U1.18
