kristianhentschel/REDEUCE/hardware/v1/lamps-12-mag.kicad_pcb

## KiCad design hardware/v1/lamps-12-mag.kicad_pcb (2016-09-02)

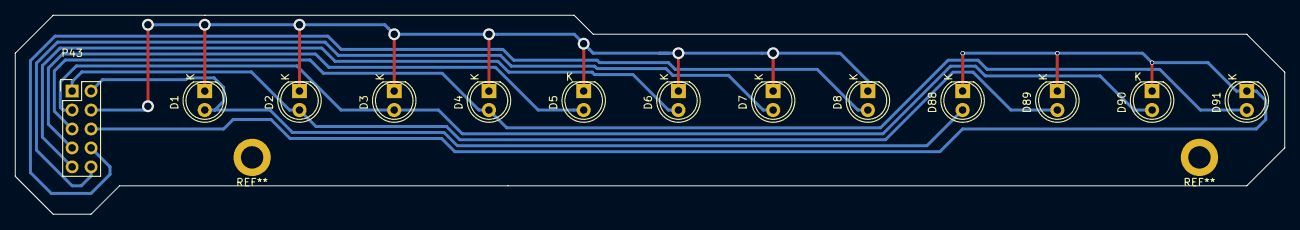
[picture p15: board lamps-12-mag.kicad_pcb from above]

Board: 2 copper layers, 170.2 x 26.7 mm, 13 parts (0 on the bottom side), 10 nets.

Parts:
D1, D2, D3, D4, D5, D6, D7, D8, D88, D89, D90, D91: LED; LED-5MM-custom
P43: CONN_02X05; Pin_Header_Straight_2x05

Connections:
/DIGITA: D1.1, D2.1, D3.1, D4.1, D5.1, D6.1, D7.1, D8.1, P43.4
/DIGITB: D88.1, D89.1, D90.1, D91.1, P43.6
/SEG0: D1.2, D88.2, P43.2
/SEG1: D2.2, D89.2, P43.1
/SEG2: D3.2, D90.2, P43.3
/SEG3: D4.2, D91.2, P43.5
/SEG4: D5.2, P43.7
/SEG5: D6.2, P43.9
/SEG6: D7.2, P43.10
/SEG7: D8.2, P43.8
