kristianhentschel/REDEUCE/hardware/v1/piconnect.kicad_pcb

## KiCad design hardware/v1/piconnect.kicad_pcb (2016-09-02)

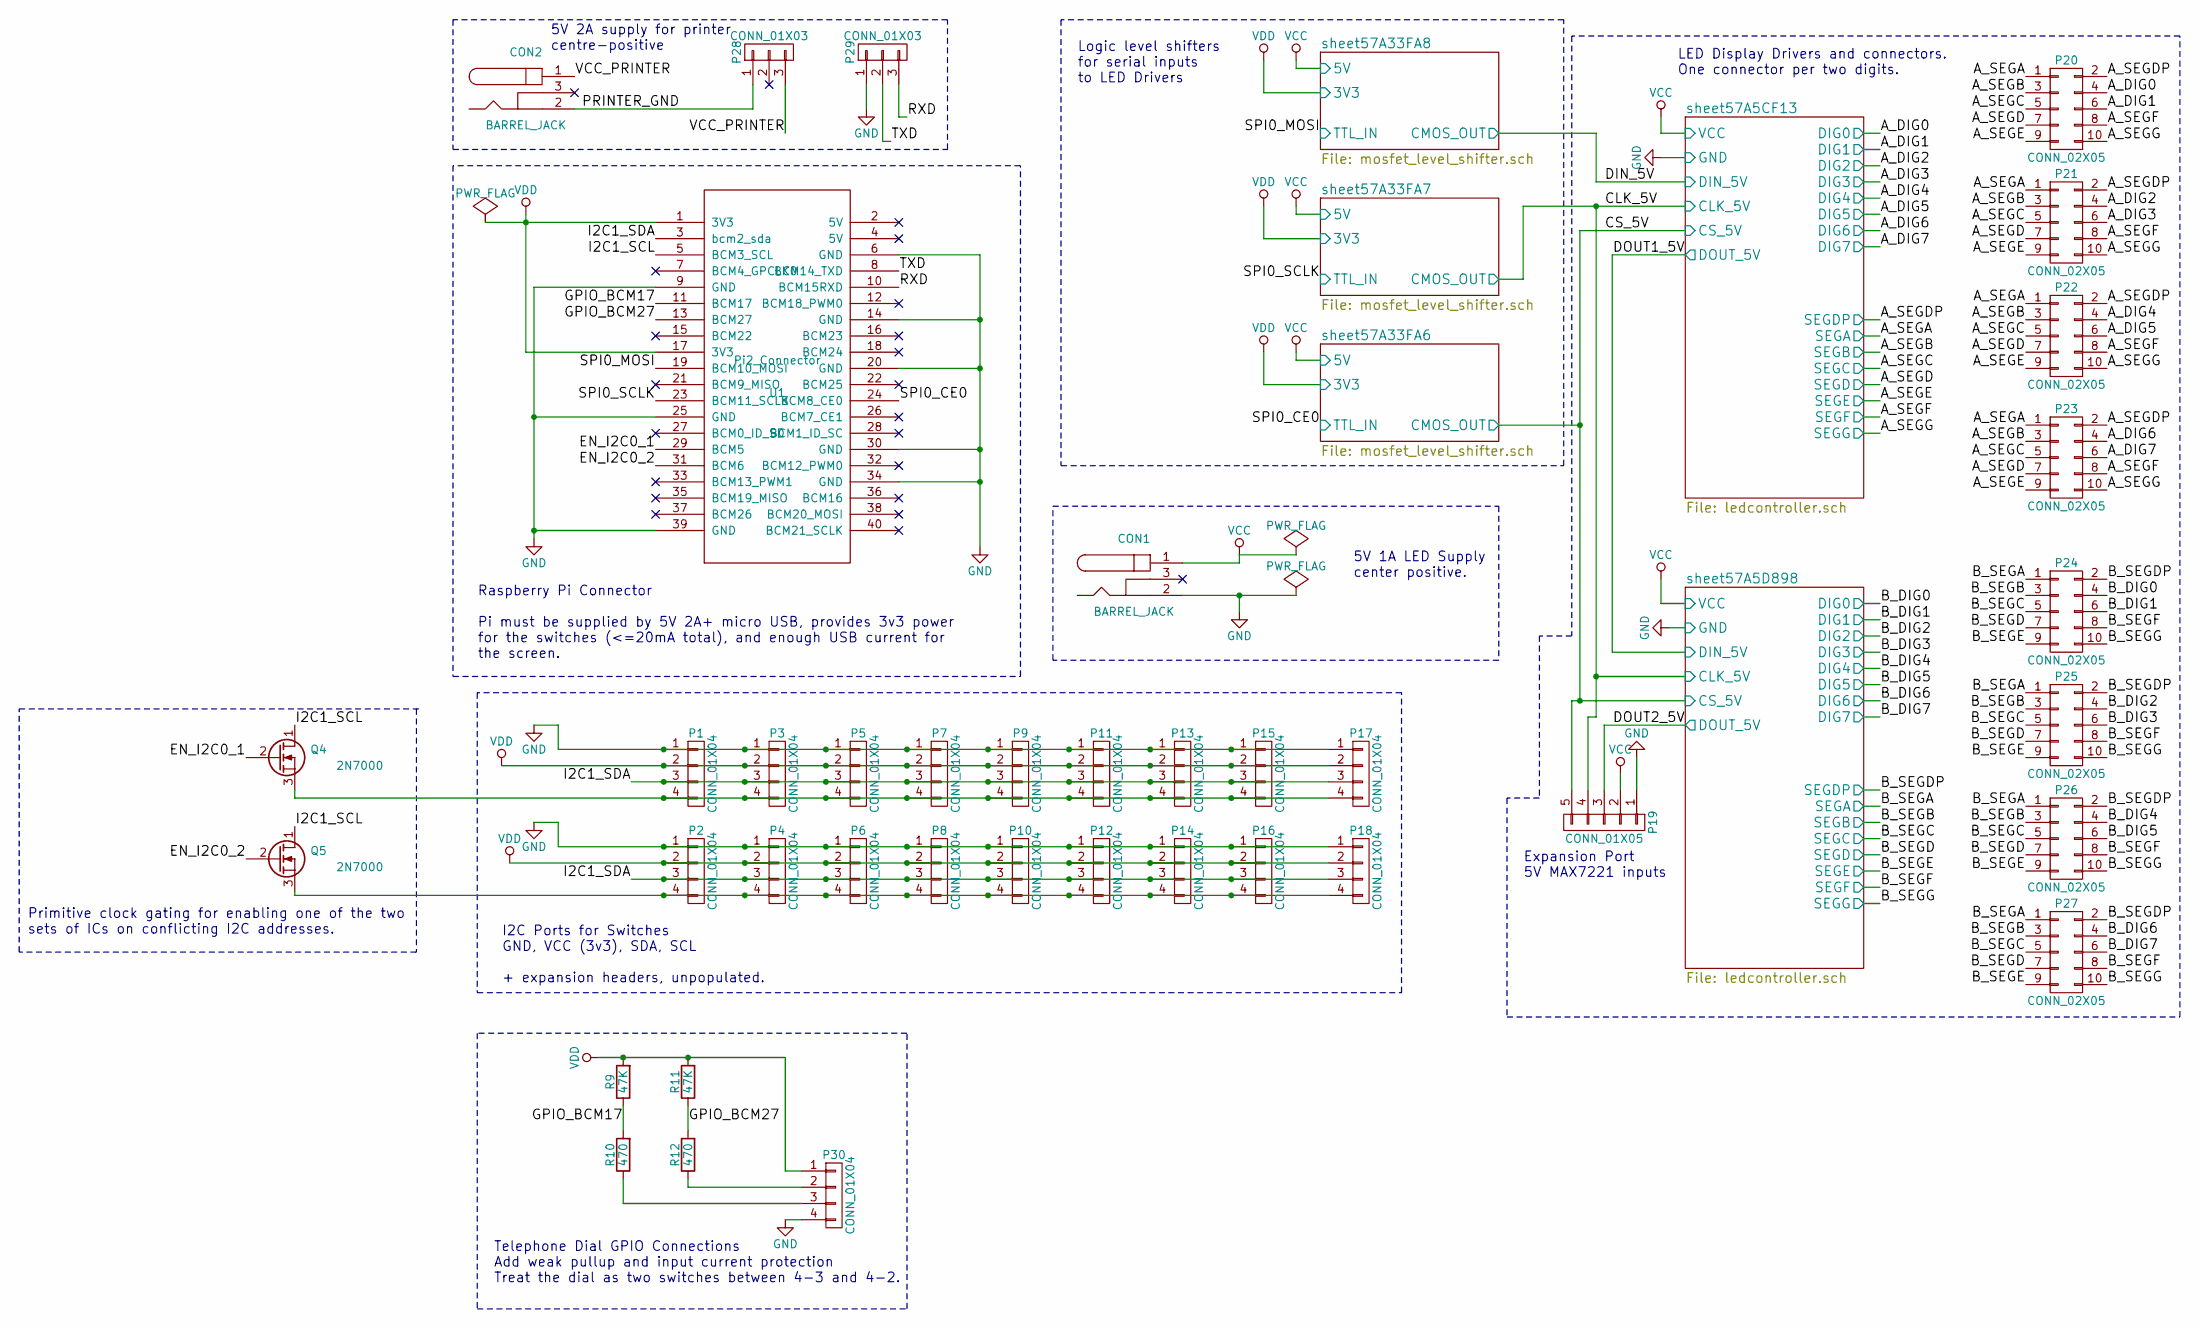
[picture p16: schematic piconnect.sch]

Parts:
CON1, CON2: BARREL_JACK; BARREL_JACK-custom
P1, P2, P3, P4, P5, P6, P7, P8, P9, P10, P11, P12, P13, P14, P15, P16, P17, P18, P30: CONN_01X04; Pin_Header_Straight_1x04
P19: CONN_01X05; Pin_Header_Straight_1x05
P20, P21, P22, P23, P24, P25, P26, P27: CONN_02X05; Pin_Header_Straight_2x05
P28, P29: CONN_01X03; Pin_Header_Straight_1x03
Q4, Q5: 2N7000; TO-92_Inline_Wide
R9, R11: 47K; Resistor_Horizontal_RM10mm
R10, R12: 470; Resistor_Horizontal_RM10mm
U1: Pi2_Connector; Pin_Header_Straight_2x20

Connections:
/EN_I2C0_1: Q4.2 (G), U1.29 (BCM5)
/EN_I2C0_2: Q5.2 (G), U1.31 (BCM6)
/GPIO_BCM17: R9.1, R10.2, U1.11 (BCM17)
/GPIO_BCM27: R11.1, R12.2, U1.13 (BCM27)
/I2C1_SCL: Q4.1 (D), Q5.1 (D), U1.5 (BCM3_SCL)
/I2C1_SDA: P1.3, P2.3, P3.3, P4.3, P5.3, P6.3, P7.3, P8.3, P9.3, P10.3, P11.3, P12.3, P13.3, P14.3, P15.3, P16.3, P17.3, P18.3, U1.3 (bcm2_sda)
/PRINTER_GND: CON2.2, P28.1
/RXD: P29.3, U1.10 (BCM15RXD)
/TXD: P29.2, U1.8 (BCM14_TXD)
/VCC_PRINTER: CON2.1, P28.3
/sheet57A5CF13/CLK_5V: P19.4; also elsewhere on the board
/sheet57A5CF13/DIG0: P20.4; also elsewhere on the board
/sheet57A5CF13/DIG1: P20.6; also elsewhere on the board
/sheet57A5CF13/DIG2: P21.4; also elsewhere on the board
/sheet57A5CF13/DIG3: P21.6; also elsewhere on the board
/sheet57A5CF13/DIG4: P22.4; also elsewhere on the board
/sheet57A5CF13/DIG5: P22.6; also elsewhere on the board
/sheet57A5CF13/DIG6: P23.4; also elsewhere on the board
/sheet57A5CF13/DIG7: P23.6; also elsewhere on the board
/sheet57A5CF13/SEGA: P20.1, P21.1, P22.1, P23.1; also elsewhere on the board
/sheet57A5CF13/SEGB: P20.3, P21.3, P22.3, P23.3; also elsewhere on the board
/sheet57A5CF13/SEGC: P20.5, P21.5, P22.5, P23.5; also elsewhere on the board
/sheet57A5CF13/SEGD: P20.7, P21.7, P22.7, P23.7; also elsewhere on the board
/sheet57A5CF13/SEGDP: P20.2, P21.2, P22.2, P23.2; also elsewhere on the board
/sheet57A5CF13/SEGE: P20.9, P21.9, P22.9, P23.9; also elsewhere on the board
/sheet57A5CF13/SEGF: P20.8, P21.8, P22.8, P23.8; also elsewhere on the board
/sheet57A5CF13/SEGG: P20.10, P21.10, P22.10, P23.10; also elsewhere on the board
/sheet57A5D898/DIG0: P24.4; also elsewhere on the board
/sheet57A5D898/DIG1: P24.6; also elsewhere on the board
/sheet57A5D898/DIG2: P25.4; also elsewhere on the board
/sheet57A5D898/DIG3: P25.6; also elsewhere on the board
/sheet57A5D898/DIG4: P26.4; also elsewhere on the board
/sheet57A5D898/DIG5: P26.6; also elsewhere on the board
/sheet57A5D898/DIG6: P27.4; also elsewhere on the board
/sheet57A5D898/DIG7: P27.6; also elsewhere on the board
/sheet57A5D898/DOUT_5V: P19.3; also elsewhere on the board
/sheet57A5D898/SEGA: P24.1, P25.1, P26.1, P27.1; also elsewhere on the board
/sheet57A5D898/SEGB: P24.3, P25.3, P26.3, P27.3; also elsewhere on the board
/sheet57A5D898/SEGC: P24.5, P25.5, P26.5, P27.5; also elsewhere on the board
/sheet57A5D898/SEGD: P24.7, P25.7, P26.7, P27.7; also elsewhere on the board
/sheet57A5D898/SEGDP: P24.2, P25.2, P26.2, P27.2; also elsewhere on the board
/sheet57A5D898/SEGE: P24.9, P25.9, P26.9, P27.9; also elsewhere on the board
/sheet57A5D898/SEGF: P24.8, P25.8, P26.8, P27.8; also elsewhere on the board
/sheet57A5D898/SEGG: P24.10, P25.10, P26.10, P27.10; also elsewhere on the board
/sheet57A33FA6/CMOS_OUT: P19.5; also elsewhere on the board
/sheet57A33FA6/TTL_IN: U1.24 (BCM8_CE0); also elsewhere on the board
/sheet57A33FA7/TTL_IN: U1.23 (BCM11_SCLK); also elsewhere on the board
/sheet57A33FA8/TTL_IN: U1.19 (BCM10_MOSI); also elsewhere on the board
GND: CON1.2, P1.1, P2.1, P3.1, P4.1, P5.1, P6.1, P7.1, P8.1, P9.1, P10.1, P11.1, P12.1, P13.1, P14.1, P15.1, P16.1, P17.1, P18.1, P19.1, P29.1, P30.4, U1.6 (GND), U1.9 (GND), U1.14 (GND), U1.20 (GND), U1.25 (GND), U1.30 (GND), U1.34 (GND), U1.39 (GND); also elsewhere on the board
unnamed: P1.4, P3.4, P5.4, P7.4, P9.4, P11.4, P13.4, P15.4, P17.4, Q4.3 (S)
unnamed: P2.4, P4.4, P6.4, P8.4, P10.4, P12.4, P14.4, P16.4, P18.4, Q5.3 (S)
unnamed: P30.2, R12.1
unnamed: P30.3, R10.1
VCC: CON1.1, P19.2; also elsewhere on the board
VDD: P1.2, P2.2, P3.2, P4.2, P5.2, P6.2, P7.2, P8.2, P9.2, P10.2, P11.2, P12.2, P13.2, P14.2, P15.2, P16.2, P17.2, P18.2, P30.1, R9.2, R11.2, U1.1 (3V3), U1.17 (3V3); also elsewhere on the board

Notes on the sheet:
5V 1A LED Supply center positive.
Raspberry Pi Connector Pi must be supplied by 5V 2A+ micro USB, provides 3v3 power for the switches (<=20mA total), and enough USB current for the screen.
Expansion Port 5V MAX7221 inputs
I2C Ports for Switches GND, VCC (3v3), SDA, SCL + expansion headers, unpopulated.
LED Display Drivers and connectors. One connector per two digits.
Logic level shifters for serial inputs to LED Drivers
5V 2A supply for printer centre-positive
Telephone Dial GPIO Connections Add weak pullup and input current protection Treat the dial as two switches between 4-3 and 4-2.
Primitive clock gating for enabling one of the two sets of ICs on conflicting I2C addresses.

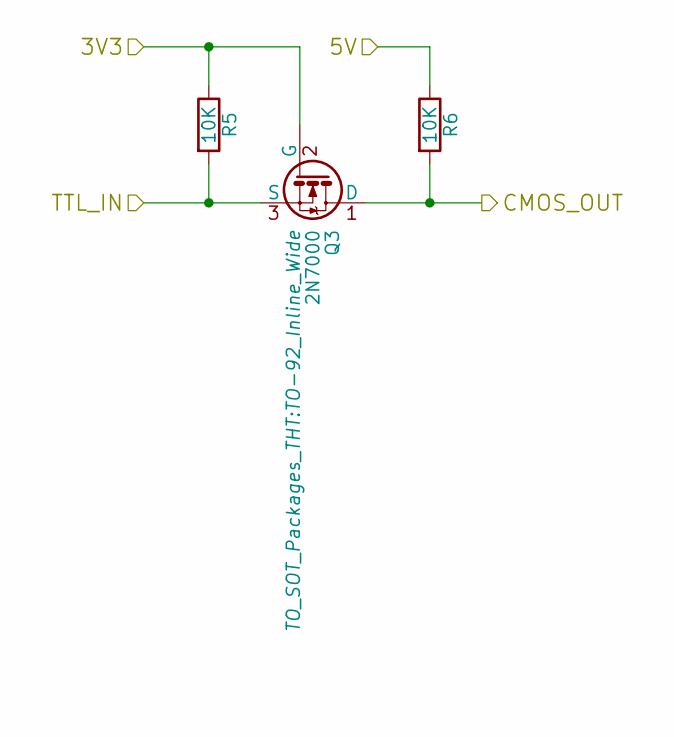
[picture p17: schematic mosfet_level_shifter.sch]

Parts:
Q1: 2N7000; TO-92_Inline_Wide
R1, R2: 10K; Resistor_Horizontal_RM10mm

Connections:
/sheet57A33FA6/CMOS_OUT: Q1.1 (D), R2.2; also elsewhere on the board
/sheet57A33FA6/TTL_IN: Q1.3 (S), R1.2; also elsewhere on the board
VCC: R2.1; also elsewhere on the board
VDD: Q1.2 (G), R1.1; also elsewhere on the board

Parts of its further copies:
Q2, Q3: 2N7000; TO-92_Inline_Wide
R3, R4, R5, R6: 10K; Resistor_Horizontal_RM10mm

Connections of its further copies:
/sheet57A5CF13/CLK_5V: Q2.1 (D), R4.2; also elsewhere on the board
/sheet57A33FA7/TTL_IN: Q2.3 (S), R3.2; also elsewhere on the board
/sheet57A33FA8/CMOS_OUT: Q3.1 (D), R6.2; also elsewhere on the board
/sheet57A33FA8/TTL_IN: Q3.3 (S), R5.2; also elsewhere on the board
VCC: R4.1, R6.1; also elsewhere on the board
VDD: Q2.2 (G), Q3.2 (G), R3.1, R5.1; also elsewhere on the board

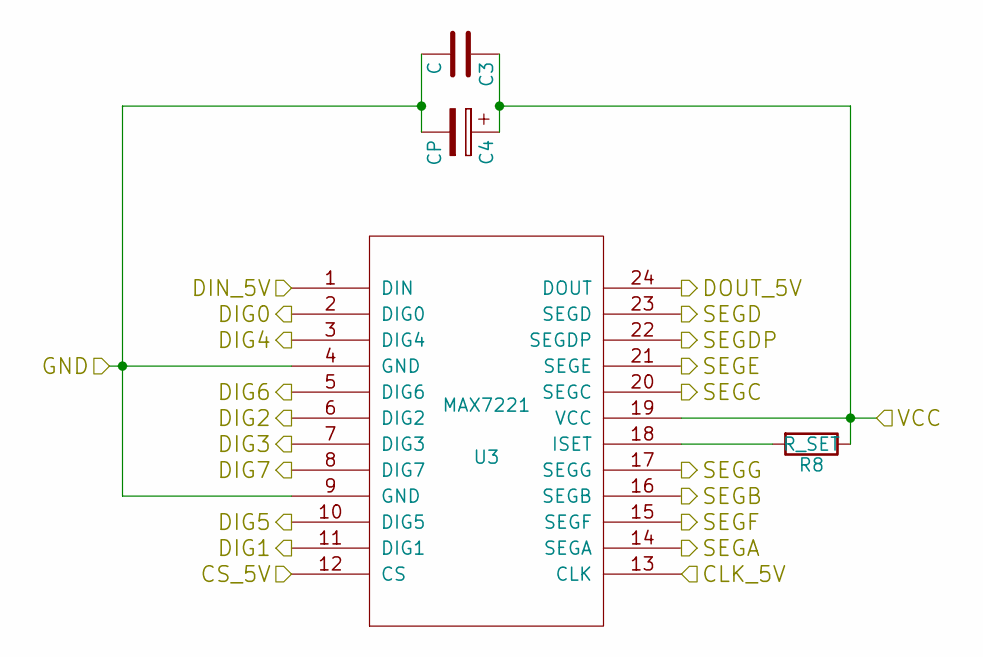
[picture p18: schematic ledcontroller.sch]

Parts:
C1: C; C_Disc_D6_P5
C2: CP; C_Radial_D5_L11_P2
R7: R_SET; Resistor_Horizontal_RM10mm
U2: MAX7221; DIL24

Connections:
/sheet57A5CF13/CLK_5V: U2.13 (CLK); also elsewhere on the board
/sheet57A5CF13/DIG0: U2.2 (DIG0); also elsewhere on the board
/sheet57A5CF13/DIG1: U2.11 (DIG1); also elsewhere on the board
/sheet57A5CF13/DIG2: U2.6 (DIG2); also elsewhere on the board
/sheet57A5CF13/DIG3: U2.7 (DIG3); also elsewhere on the board
/sheet57A5CF13/DIG4: U2.3 (DIG4); also elsewhere on the board
/sheet57A5CF13/DIG5: U2.10 (DIG5); also elsewhere on the board
/sheet57A5CF13/DIG6: U2.5 (DIG6); also elsewhere on the board
/sheet57A5CF13/DIG7: U2.8 (DIG7); also elsewhere on the board
/sheet57A5CF13/SEGA: U2.14 (SEGA); also elsewhere on the board
/sheet57A5CF13/SEGB: U2.16 (SEGB); also elsewhere on the board
/sheet57A5CF13/SEGC: U2.20 (SEGC); also elsewhere on the board
/sheet57A5CF13/SEGD: U2.23 (SEGD); also elsewhere on the board
/sheet57A5CF13/SEGDP: U2.22 (SEGDP); also elsewhere on the board
/sheet57A5CF13/SEGE: U2.21 (SEGE); also elsewhere on the board
/sheet57A5CF13/SEGF: U2.15 (SEGF); also elsewhere on the board
/sheet57A5CF13/SEGG: U2.17 (SEGG); also elsewhere on the board
/sheet57A5D898/DIN_5V: U2.24 (DOUT); also elsewhere on the board
/sheet57A33FA6/CMOS_OUT: U2.12 (CS); also elsewhere on the board
/sheet57A33FA8/CMOS_OUT: U2.1 (DIN); also elsewhere on the board
GND: C1.2, C2.2, U2.4 (GND), U2.9 (GND); also elsewhere on the board
unnamed: R7.2, U2.18 (ISET)
VCC: C1.1, C2.1, R7.1, U2.19 (VCC); also elsewhere on the board

Parts of its further copies:
C3: C; C_Disc_D6_P5
C4: CP; C_Radial_D5_L11_P2
R8: R_SET; Resistor_Horizontal_RM10mm
U3: MAX7221; DIL24

Connections of its further copies:
/sheet57A5CF13/CLK_5V: U3.13 (CLK); also elsewhere on the board
/sheet57A5D898/DIG0: U3.2 (DIG0); also elsewhere on the board
/sheet57A5D898/DIG1: U3.11 (DIG1); also elsewhere on the board
/sheet57A5D898/DIG2: U3.6 (DIG2); also elsewhere on the board
/sheet57A5D898/DIG3: U3.7 (DIG3); also elsewhere on the board
/sheet57A5D898/DIG4: U3.3 (DIG4); also elsewhere on the board
/sheet57A5D898/DIG5: U3.10 (DIG5); also elsewhere on the board
/sheet57A5D898/DIG6: U3.5 (DIG6); also elsewhere on the board
/sheet57A5D898/DIG7: U3.8 (DIG7); also elsewhere on the board
/sheet57A5D898/DIN_5V: U3.1 (DIN); also elsewhere on the board
/sheet57A5D898/DOUT_5V: U3.24 (DOUT); also elsewhere on the board
/sheet57A5D898/SEGA: U3.14 (SEGA); also elsewhere on the board
/sheet57A5D898/SEGB: U3.16 (SEGB); also elsewhere on the board
/sheet57A5D898/SEGC: U3.20 (SEGC); also elsewhere on the board
/sheet57A5D898/SEGD: U3.23 (SEGD); also elsewhere on the board
/sheet57A5D898/SEGDP: U3.22 (SEGDP); also elsewhere on the board
/sheet57A5D898/SEGE: U3.21 (SEGE); also elsewhere on the board
/sheet57A5D898/SEGF: U3.15 (SEGF); also elsewhere on the board
/sheet57A5D898/SEGG: U3.17 (SEGG); also elsewhere on the board
/sheet57A33FA6/CMOS_OUT: U3.12 (CS); also elsewhere on the board
GND: C3.2, C4.2, U3.4 (GND), U3.9 (GND); also elsewhere on the board
unnamed: R8.2, U3.18 (ISET)
VCC: C3.1, C4.1, R8.1, U3.19 (VCC); also elsewhere on the board

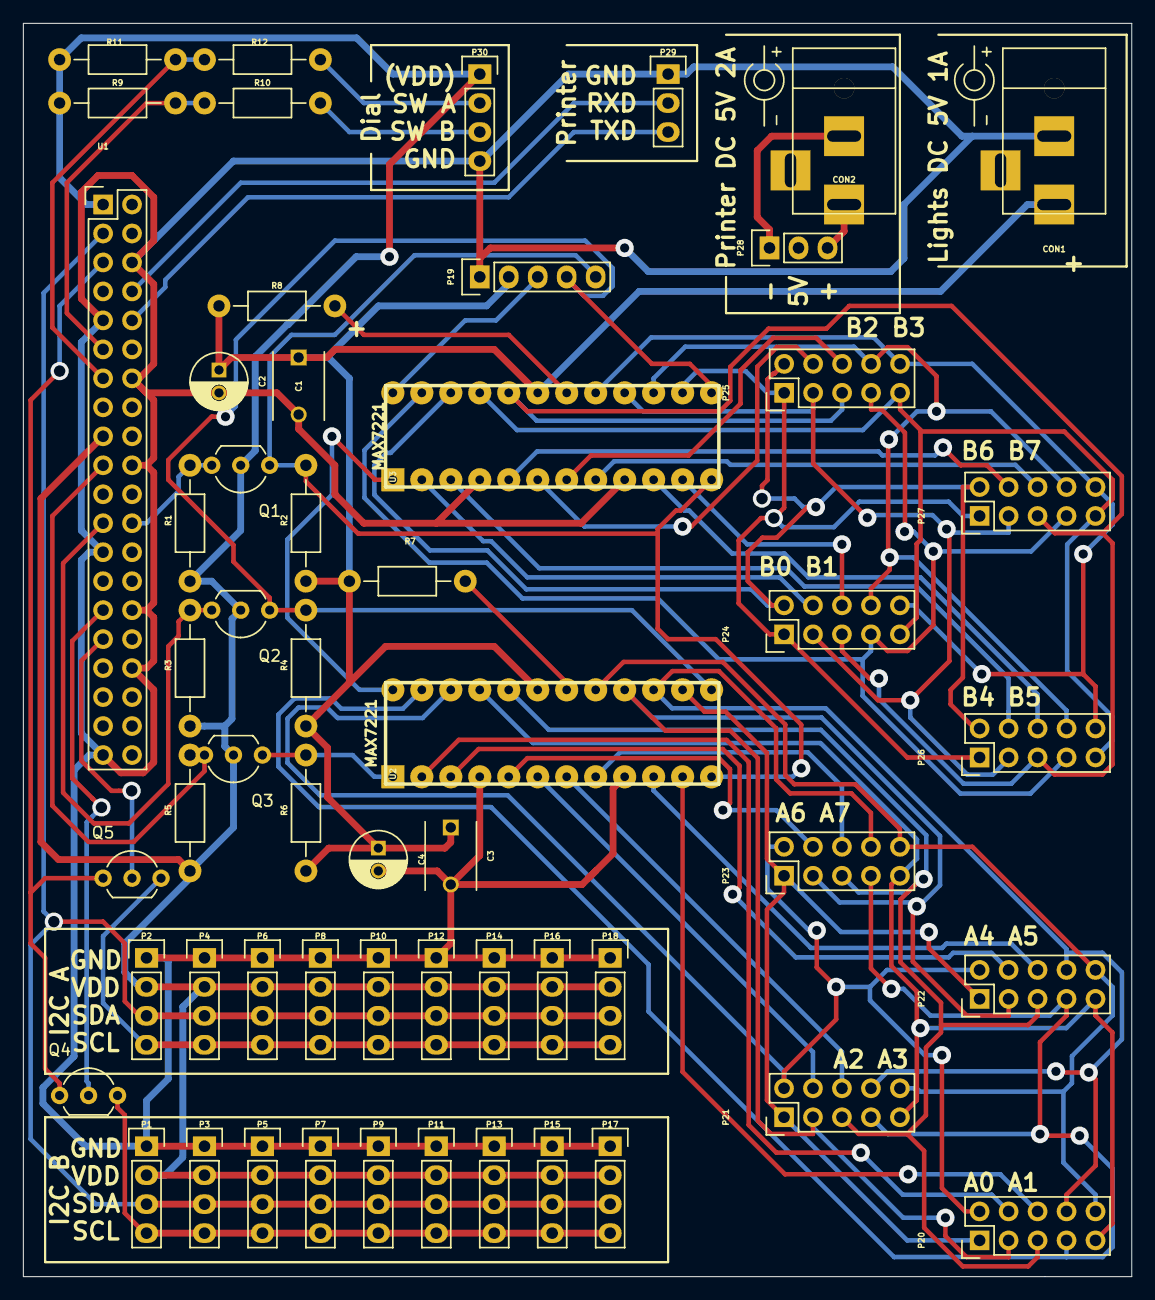
[picture p19: board piconnect.kicad_pcb from above]

Board: 2 copper layers, 97.2 x 109.9 mm, 56 parts (0 on the bottom side), 59 nets.
