kristianhentschel/REDEUCE/hardware/v1/keys-6.kicad_pcb

## KiCad design hardware/v1/keys-6.kicad_pcb (2016-09-02)

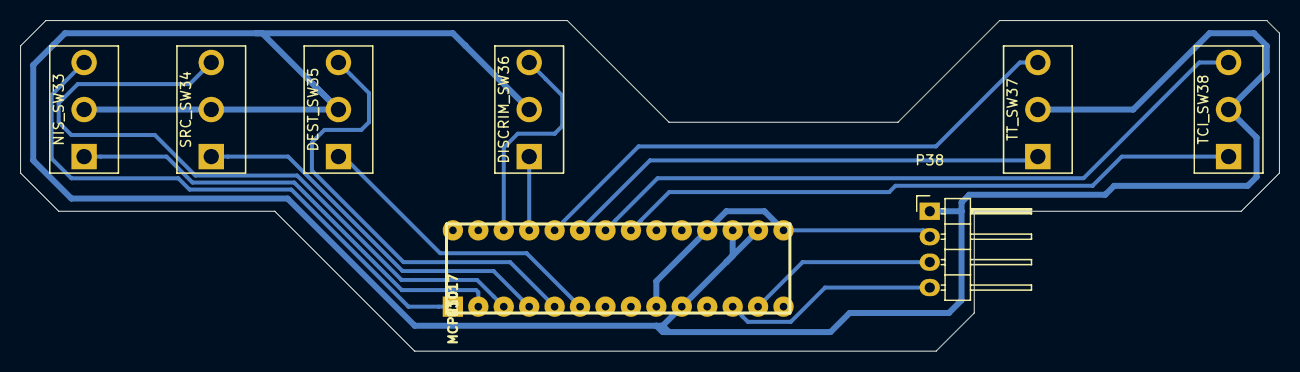
[picture p20: board keys-6.kicad_pcb from above]

Board: 2 copper layers, 125.7 x 33.0 mm, 8 parts (0 on the bottom side), 16 nets.

Parts:
DEST_SW35: SWITCH_INV; SW_SPDT-custom
DISCRIM_SW36: SWITCH_INV; SW_SPDT-custom
NIS_SW33: SWITCH_INV; SW_SPDT-custom
P38: CONN_01X04; Pin_Header_Angled_1x04
SRC_SW34: SWITCH_INV; SW_SPDT-custom
TCI_SW38: SWITCH_INV; SW_SPDT-custom
TT_SW37: SWITCH_INV; SW_SPDT-custom
U10: MCP23017; DIL28

Connections:
/DEST_A: DEST_SW35.1, U10.6
/DEST_B: DEST_SW35.3, U10.5
/DISCRIM_A: DISCRIM_SW36.1, U10.25
/DISCRIM_B: DISCRIM_SW36.3, U10.26
/NIS_A: NIS_SW33.1, U10.2
/NIS_B: NIS_SW33.3, U10.1
/SCK: P38.4, U10.12
/SDA: P38.3, U10.13
/SRC_A: SRC_SW34.1, U10.4
/SRC_B: SRC_SW34.3, U10.3
/TCI_A: TCI_SW38.1, U10.21
/TCI_B: TCI_SW38.3, U10.22
/TT_A: TT_SW37.1, U10.23
/TT_B: TT_SW37.3, U10.24
GND: DEST_SW35.2, DISCRIM_SW36.2, NIS_SW33.2, P38.1, SRC_SW34.2, TCI_SW38.2, TT_SW37.2, U10.10, U10.16, U10.17
VDD: P38.2, U10.9, U10.15, U10.18
