kristianhentschel/REDEUCE/hardware/v1/delaylineselect.kicad_pcb

## KiCad design hardware/v1/delaylineselect.kicad_pcb (2016-09-02)

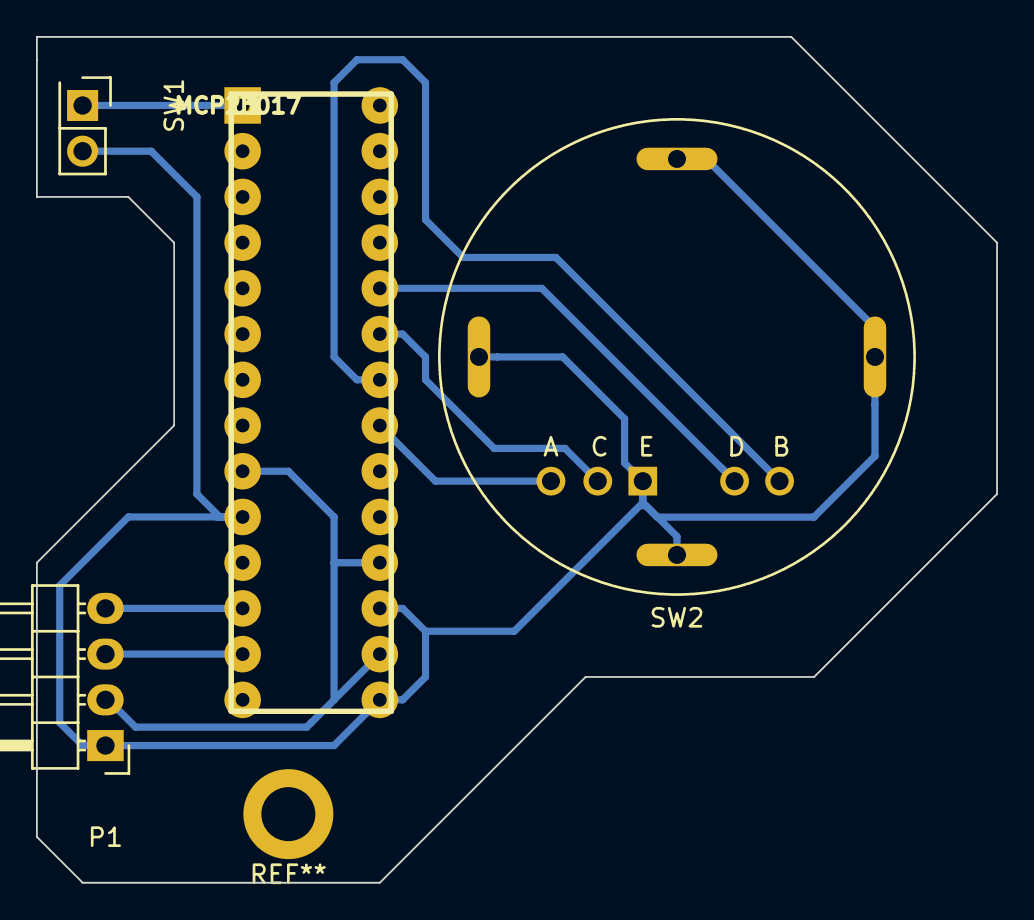
[picture p21: board delaylineselect.kicad_pcb from above]

Board: 2 copper layers, 53.3 x 47.0 mm, 4 parts (0 on the bottom side), 9 nets.

Parts:
P1: CONN_01X04; Pin_Header_Angled_1x04
SW1: SW_PUSH; Pin_Header_Straight_2x01
SW2: Coded_Switch; ROTARY_BCK1002-custom
U1: MCP23017; DIL28

Connections:
/MCSLIP: SW1.1, U1.1
/SCK: P1.4, U1.12
/SDA: P1.3, U1.13
/SELECT_A: SW2.2, U1.21
/SELECT_B: SW2.3, U1.22
/SELECT_C: SW2.4, U1.23
/SELECT_D: SW2.5, U1.24
GND: P1.1, SW1.2, SW2.1, U1.10, U1.15, U1.17
VDD: P1.2, U1.9, U1.16, U1.18
