kristianhentschel/REDEUCE/hardware/v1/lamps-4-3.kicad_pcb

## KiCad design hardware/v1/lamps-4-3.kicad_pcb (2016-09-02)

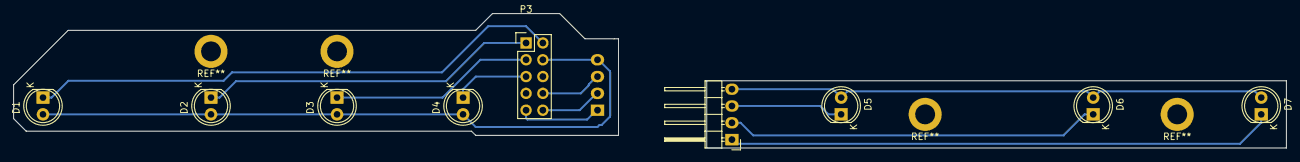
[picture p22: board lamps-4-3.kicad_pcb from above]

Board: 2 copper layers, 192.4 x 20.3 mm, 10 parts (1 on the bottom side), 12 nets.

Parts:
D1, D2, D3, D4, D5, D6, D7: LED; LED-5MM-custom
P1, P2: CONN_01X04; Pin_Header_Angled_1x04
P3: CONN_02X05; Pin_Header_Straight_2x05

Connections:
/DIGITA: D1.2, D2.2, D3.2, D4.2, P1.4, P3.4
/SEG0: D1.1, P3.2
/SEG1: D2.1, P3.1
/SEG2: D3.1, P3.3
/SEG3: D4.1, P3.5
/SEG5: P1.1, P3.9
/SEG6: P1.2, P3.10
/SEG7: P1.3, P3.8
unnamed: D5.1, P2.3
unnamed: D5.2, D6.2, D7.2, P2.4
unnamed: D6.1, P2.2
unnamed: D7.1, P2.1
