kristianhentschel/REDEUCE/hardware/prototype/driversandbox/driversandbox.kicad_pcb

## KiCad design hardware/prototype/driversandbox/driversandbox.kicad_pcb (2016-08-31)

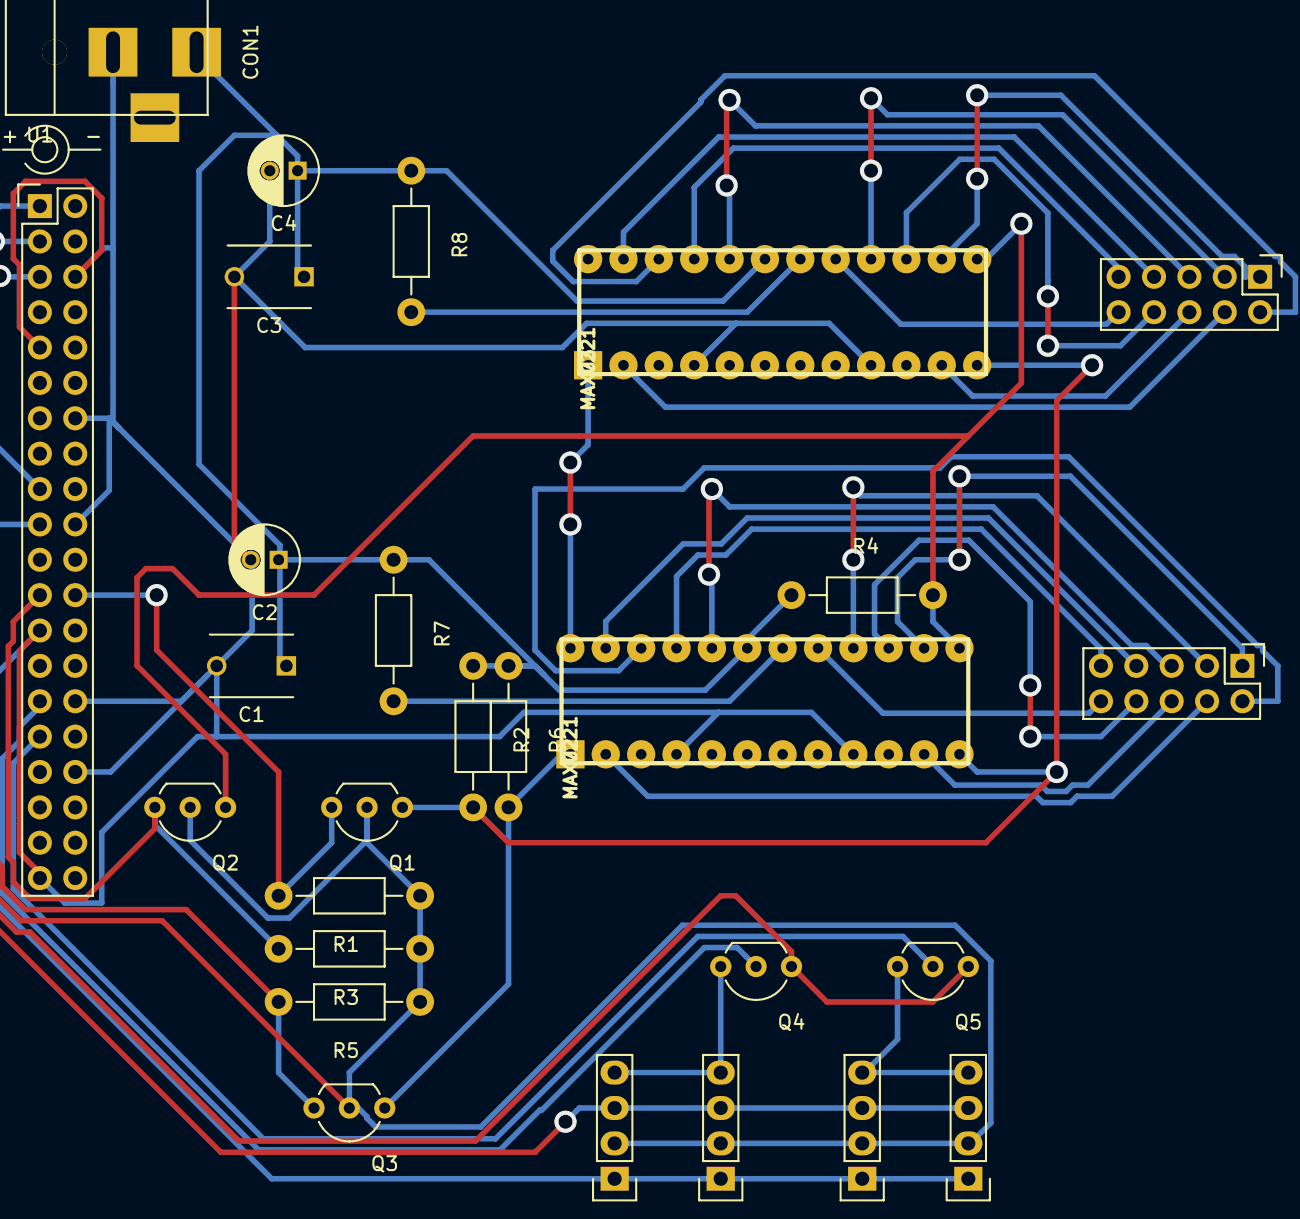
[picture p23: board driversandbox.kicad_pcb from above]

Board: 2 copper layers, 27 parts (0 on the bottom side), 38 nets.

Parts:
C1, C3: C; C_Disc_D6_P5
C2, C4: CP; C_Radial_D5_L11_P2
CON1: BARREL_JACK; BARREL_JACK-custom
P1, P2, P3, P4: CONN_01X04; Pin_Header_Straight_1x04
P20, P24: CONN_02X05; Pin_Header_Straight_2x05
Q1, Q2, Q3, Q4, Q5: 2N7000; TO-92_Inline_Wide
R1, R2, R3, R4, R5, R6: 10K; Resistor_Horizontal_RM10mm
R7, R8: R_SET; Resistor_Horizontal_RM10mm
U1: Pi2_Connector; Pin_Header_Straight_2x20
U2, U3: MAX7221; DIL24

Connections:
/EN_I2C0_1: Q4.2, U1.29
/EN_I2C0_2: Q5.2, U1.31
/I2C1_SCL: Q4.1, Q5.1, U1.5
/I2C1_SDA: P1.3, P2.3, P3.3, P4.3, U1.3
/sheet57A5CF13/CLK_5V: Q2.1, R4.2, U2.13, U3.13
/sheet57A5CF13/DIG0: P20.4, U2.2
/sheet57A5CF13/DIG1: P20.6, U2.11
/sheet57A5CF13/SEGA: P20.1, U2.14
/sheet57A5CF13/SEGB: P20.3, U2.16
/sheet57A5CF13/SEGC: P20.5, U2.20
/sheet57A5CF13/SEGD: P20.7, U2.23
/sheet57A5CF13/SEGDP: P20.2, U2.22
/sheet57A5CF13/SEGE: P20.9, U2.21
/sheet57A5CF13/SEGF: P20.8, U2.15
/sheet57A5CF13/SEGG: P20.10, U2.17
/sheet57A5D898/DIG0: P24.4, U3.2
/sheet57A5D898/DIG1: P24.6, U3.11
/sheet57A5D898/DIN_5V: U2.24, U3.1
/sheet57A5D898/SEGA: P24.1, U3.14
/sheet57A5D898/SEGB: P24.3, U3.16
/sheet57A5D898/SEGC: P24.5, U3.20
/sheet57A5D898/SEGD: P24.7, U3.23
/sheet57A5D898/SEGDP: P24.2, U3.22
/sheet57A5D898/SEGE: P24.9, U3.21
/sheet57A5D898/SEGF: P24.8, U3.15
/sheet57A5D898/SEGG: P24.10, U3.17
/sheet57A33FA6/CMOS_OUT: Q1.1, R2.2, U2.12, U3.12
/sheet57A33FA6/TTL_IN: Q1.3, R1.2, U1.24
/sheet57A33FA7/TTL_IN: Q2.3, R3.2, U1.23
/sheet57A33FA8/CMOS_OUT: Q3.1, R6.2, U2.1
/sheet57A33FA8/TTL_IN: Q3.3, R5.2, U1.19
GND: C1.2, C2.2, C3.2, C4.2, CON1.2, P1.1, P2.1, P3.1, P4.1, U1.6, U1.9, U1.14, U1.20, U1.25, U1.30, U1.34, U1.39, U2.4, U2.9, U3.4, U3.9
unnamed: P1.4, P3.4, Q4.3
unnamed: P2.4, P4.4, Q5.3
unnamed: R7.2, U2.18
unnamed: R8.2, U3.18
VCC: C1.1, C2.1, C3.1, C4.1, CON1.1, R2.1, R4.1, R6.1, R7.1, R8.1, U2.19, U3.19
VDD: P1.2, P2.2, P3.2, P4.2, Q1.2, Q2.2, Q3.2, R1.1, R3.1, R5.1, U1.1, U1.17
