kristianhentschel/REDEUCE/hardware/v1/v1.kicad_pcb

## KiCad design hardware/v1/v1.kicad_pcb (2016-08-04)

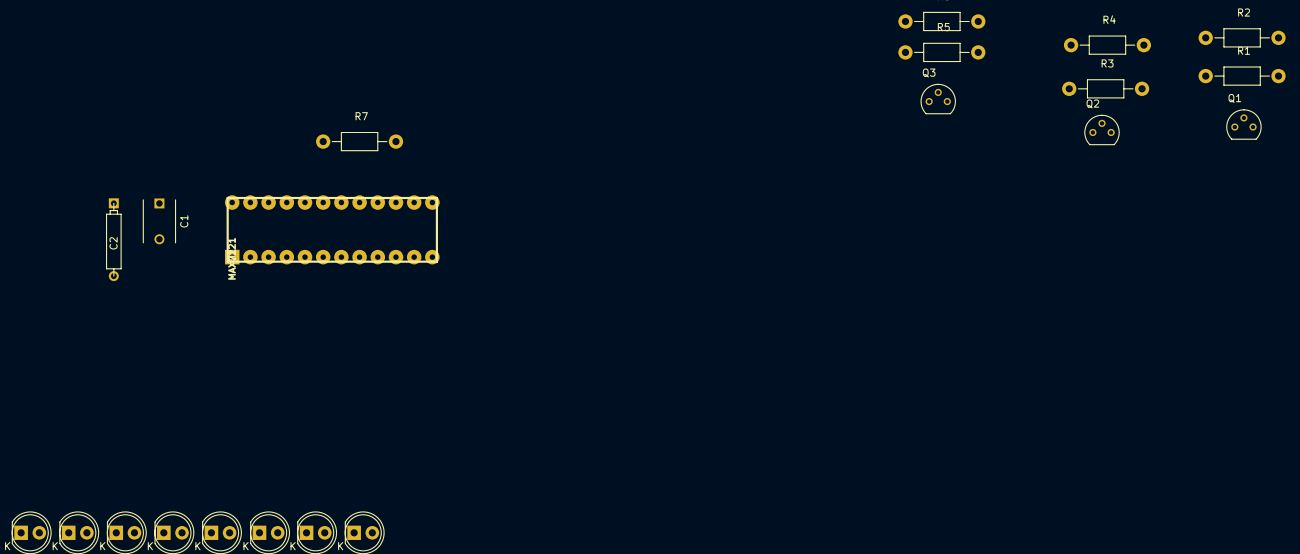
[picture p24: board v1.kicad_pcb from above]

Board: 2 copper layers, 21 parts (0 on the bottom side), 21 nets, no tracks yet.

Parts:
C1: C; C_Disc_D6_P5
C2: CP; CP4
D1, D2, D3, D4, D5, D6, D7, D8: LED; LED-5MM
Q1, Q2, Q3: 2N7000; TO-92_Molded_Narrow
R1, R2, R3, R4, R5, R6: 10K; Resistor_Horizontal_RM10mm
R7: R_SET; Resistor_Horizontal_RM10mm
U1: MAX7221; DIL24

Connections:
/ledcontroller/DIG0: D1.1, D2.1, D3.1, D4.1, D5.1, D6.1, D7.1, D8.1, U1.2
/ledcontroller/GND: C1.2, C2.2, U1.4, U1.9
/ledcontroller/VCC: C1.1, C2.1, R7.1, U1.19
/ledrow/LED0: D1.2, U1.14
/ledrow/LED1: D2.2, U1.16
/ledrow/LED2: D3.2, U1.20
/ledrow/LED3: D4.2, U1.23
/ledrow/LED4: D5.2, U1.21
/ledrow/LED5: D6.2, U1.15
/ledrow/LED6: D7.2, U1.17
/ledrow/LED7: D8.2, U1.22
/piconnect/sheet57A33FA6/3V3: Q1.2, R1.1
/piconnect/sheet57A33FA6/CMOS_OUT: Q1.1, R2.2
/piconnect/sheet57A33FA6/TTL_IN: Q1.3, R1.2
/piconnect/sheet57A33FA7/3V3: Q2.2, R3.1
/piconnect/sheet57A33FA7/CMOS_OUT: Q2.1, R4.2
/piconnect/sheet57A33FA7/TTL_IN: Q2.3, R3.2
/piconnect/sheet57A33FA8/3V3: Q3.2, R5.1
/piconnect/sheet57A33FA8/CMOS_OUT: Q3.1, R6.2
/piconnect/sheet57A33FA8/TTL_IN: Q3.3, R5.2
unnamed: R7.2, U1.18
