kristianhentschel/REDEUCE/hardware/prototype/pi_connect/prototype_pi_connect.kicad_pcb

## KiCad design hardware/prototype/pi_connect/prototype_pi_connect.kicad_pcb (2016-08-03)

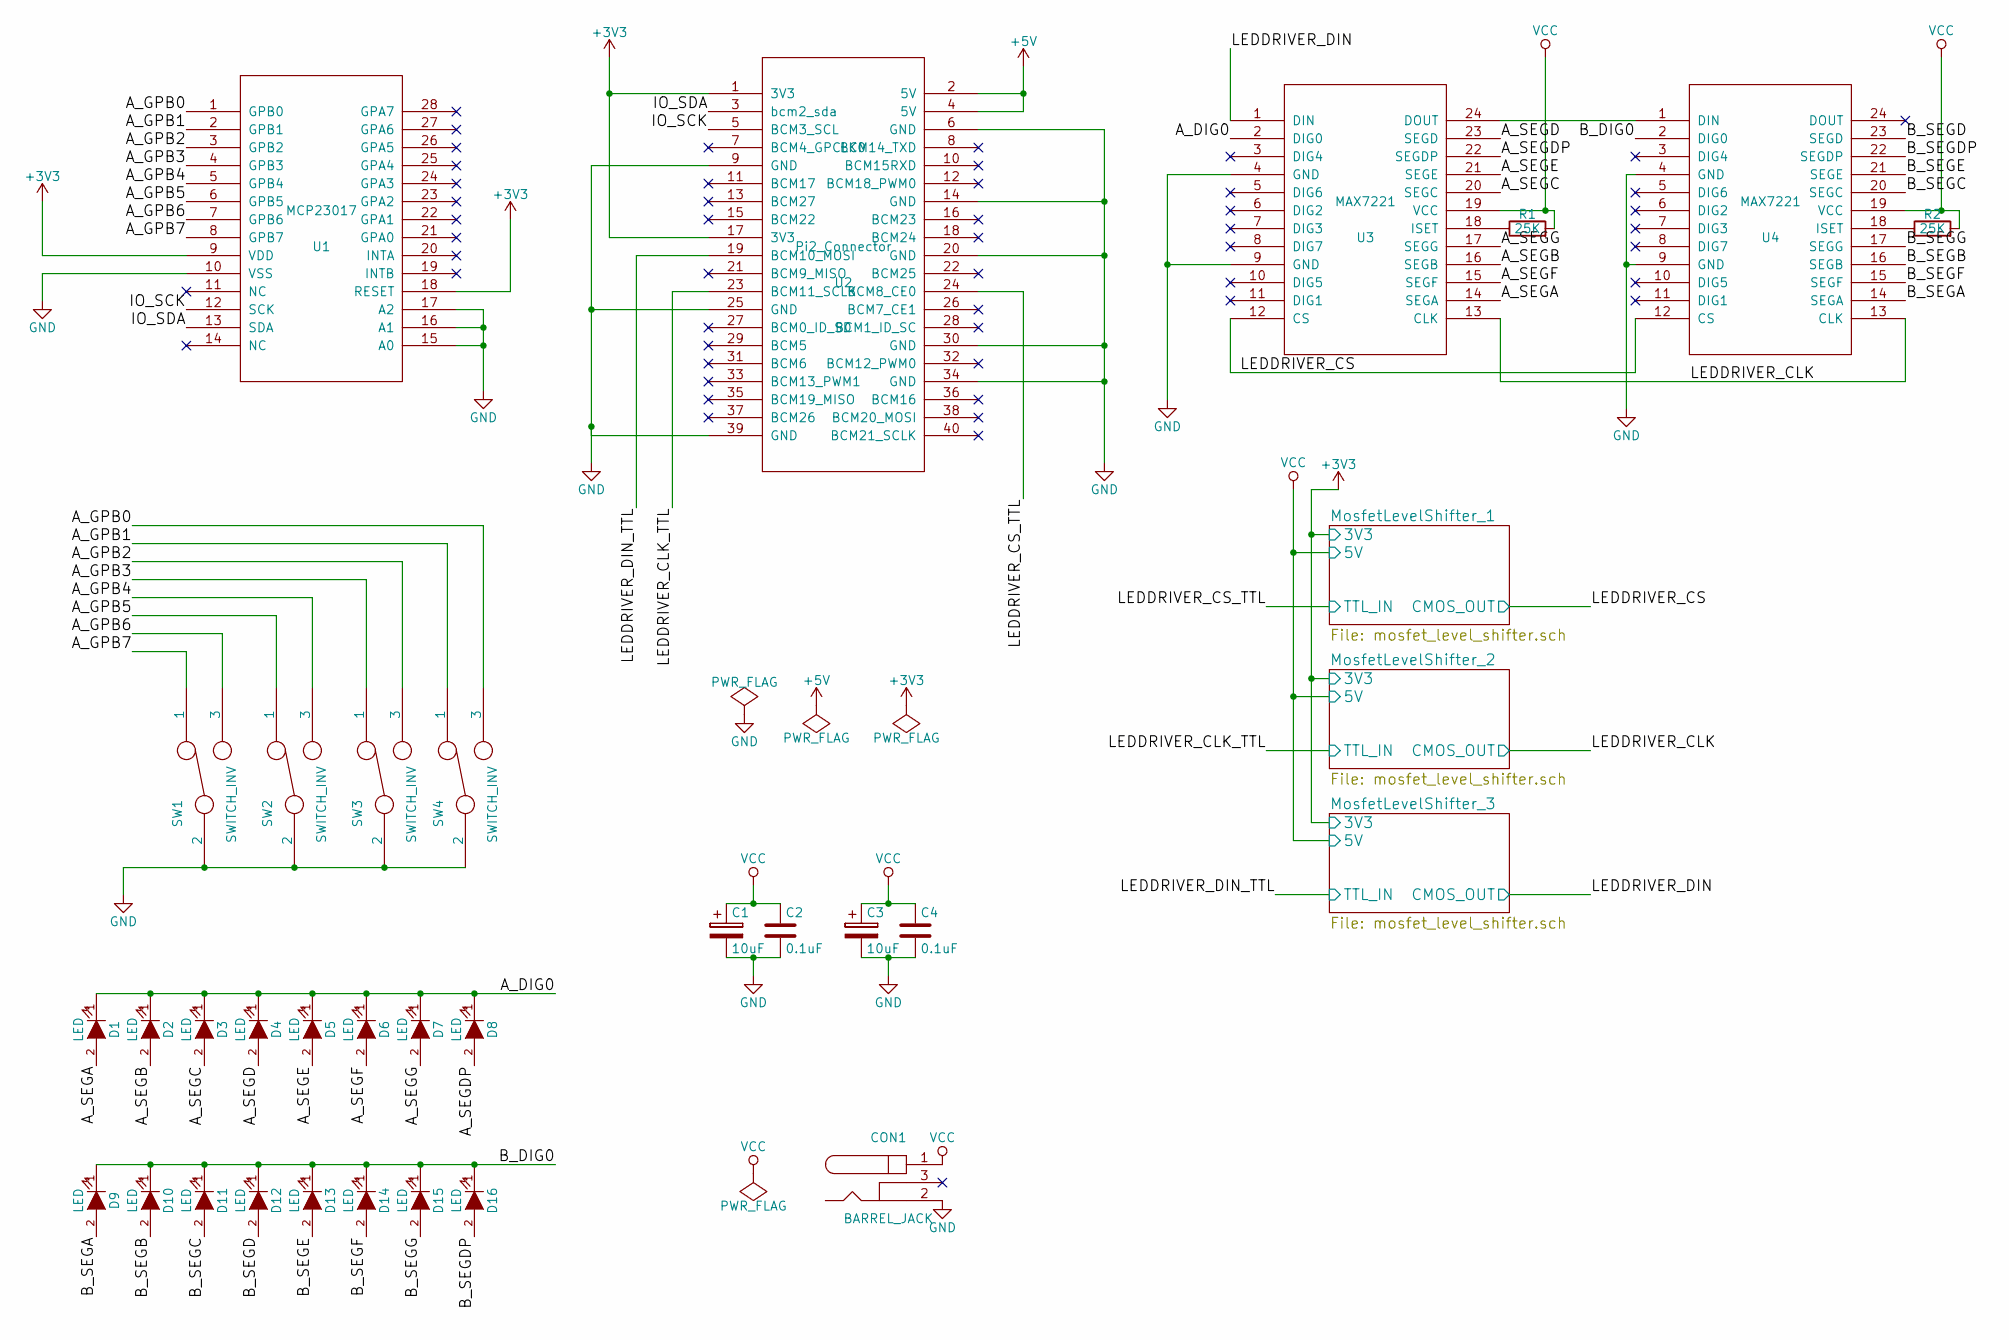
[picture p25: schematic prototype_pi_connect.sch]

Parts:
C1, C3: 10uF; CP5
C2, C4: 0.1uF; C_Disc_D6_P5
CON1: BARREL_JACK
D1, D2, D3, D4, D5, D6, D7, D8, D9, D10, D11, D12, D13, D14, D15, D16: LED; LED-5MM
R1, R2: 25K; Resistor_Horizontal_RM10mm
SW1, SW2, SW3, SW4: SWITCH_INV; SW_SPDT
U1: MCP23017; DIL28
U2: Pi2_Connector; CONN_02x20
U3, U4: MAX7221; DIL24

Connections:
+3V3: U1.9 (VDD), U1.18 (RESET), U2.1 (3V3), U2.17 (3V3); also elsewhere on the board
+5V: U2.2 (5V), U2.4 (5V)
/A_DIG0: D1.1 (K), D2.1 (K), D3.1 (K), D4.1 (K), D5.1 (K), D6.1 (K), D7.1 (K), D8.1 (K), U3.2 (DIG0)
/A_GPB0: SW4.3, U1.1 (GPB0)
/A_GPB1: SW4.1, U1.2 (GPB1)
/A_GPB2: SW3.3, U1.3 (GPB2)
/A_GPB3: SW3.1, U1.4 (GPB3)
/A_GPB4: SW2.3, U1.5 (GPB4)
/A_GPB5: SW2.1, U1.6 (GPB5)
/A_GPB6: SW1.3, U1.7 (GPB6)
/A_GPB7: SW1.1, U1.8 (GPB7)
/A_SEGA: D1.2 (A), U3.14 (SEGA)
/A_SEGB: D2.2 (A), U3.16 (SEGB)
/A_SEGC: D3.2 (A), U3.20 (SEGC)
/A_SEGD: D4.2 (A), U3.23 (SEGD)
/A_SEGDP: D8.2 (A), U3.22 (SEGDP)
/A_SEGE: D5.2 (A), U3.21 (SEGE)
/A_SEGF: D6.2 (A), U3.15 (SEGF)
/A_SEGG: D7.2 (A), U3.17 (SEGG)
/B_DIG0: D9.1 (K), D10.1 (K), D11.1 (K), D12.1 (K), D13.1 (K), D14.1 (K), D15.1 (K), D16.1 (K), U4.2 (DIG0)
/B_SEGA: D9.2 (A), U4.14 (SEGA)
/B_SEGB: D10.2 (A), U4.16 (SEGB)
/B_SEGC: D11.2 (A), U4.20 (SEGC)
/B_SEGD: D12.2 (A), U4.23 (SEGD)
/B_SEGDP: D16.2 (A), U4.22 (SEGDP)
/B_SEGE: D13.2 (A), U4.21 (SEGE)
/B_SEGF: D14.2 (A), U4.15 (SEGF)
/B_SEGG: D15.2 (A), U4.17 (SEGG)
/IO_SCK: U1.12 (SCK), U2.5 (BCM3_SCL)
/IO_SDA: U1.13 (SDA), U2.3 (bcm2_sda)
/LEDDRIVER_CLK: U3.13 (CLK), U4.13 (CLK); also elsewhere on the board
/LEDDRIVER_CLK_TTL: U2.23 (BCM11_SCLK); also elsewhere on the board
/LEDDRIVER_CS: U3.12 (CS), U4.12 (CS); also elsewhere on the board
/LEDDRIVER_CS_TTL: U2.24 (BCM8_CE0); also elsewhere on the board
/LEDDRIVER_DIN: U3.1 (DIN); also elsewhere on the board
/LEDDRIVER_DIN_TTL: U2.19 (BCM10_MOSI); also elsewhere on the board
GND: C1.2, C2.2, C3.2, C4.2, CON1.2, SW1.2, SW2.2, SW3.2, SW4.2, U1.10 (VSS), U1.15 (A0), U1.16 (A1), U1.17 (A2), U2.6 (GND), U2.9 (GND), U2.14 (GND), U2.20 (GND), U2.25 (GND), U2.30 (GND), U2.34 (GND), U2.39 (GND), U3.4 (GND), U3.9 (GND), U4.4 (GND), U4.9 (GND)
unnamed: R1.1, U3.18 (ISET)
unnamed: R2.1, U4.18 (ISET)
unnamed: U3.24 (DOUT), U4.1 (DIN)
VCC: C1.1, C2.1, C3.1, C4.1, CON1.1, R1.2, R2.2, U3.19 (VCC), U4.19 (VCC); also elsewhere on the board

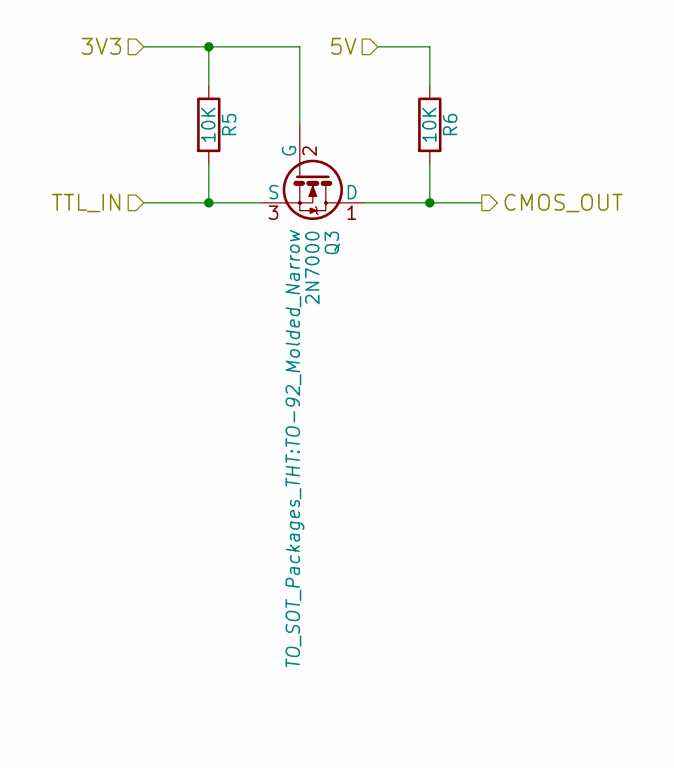
[picture p26: schematic mosfet_level_shifter.sch]

Parts:
Q1: 2N7000; TO-92_Molded_Narrow
R3, R4: 10K; Resistor_Horizontal_RM10mm

Connections:
+3V3: Q1.2 (G), R3.1; also elsewhere on the board
/LEDDRIVER_CS: Q1.1 (D), R4.2; also elsewhere on the board
/LEDDRIVER_CS_TTL: Q1.3 (S), R3.2; also elsewhere on the board
VCC: R4.1; also elsewhere on the board

Parts of its further copies:
Q2, Q3: 2N7000; TO-92_Molded_Narrow
R5, R6, R7, R8: 10K; Resistor_Horizontal_RM10mm

Connections of its further copies:
+3V3: Q2.2 (G), Q3.2 (G), R5.1, R7.1; also elsewhere on the board
/LEDDRIVER_CLK: Q2.1 (D), R8.2; also elsewhere on the board
/LEDDRIVER_CLK_TTL: Q2.3 (S), R7.2; also elsewhere on the board
/LEDDRIVER_DIN: Q3.1 (D), R6.2; also elsewhere on the board
/LEDDRIVER_DIN_TTL: Q3.3 (S), R5.2; also elsewhere on the board
VCC: R6.1, R8.1; also elsewhere on the board

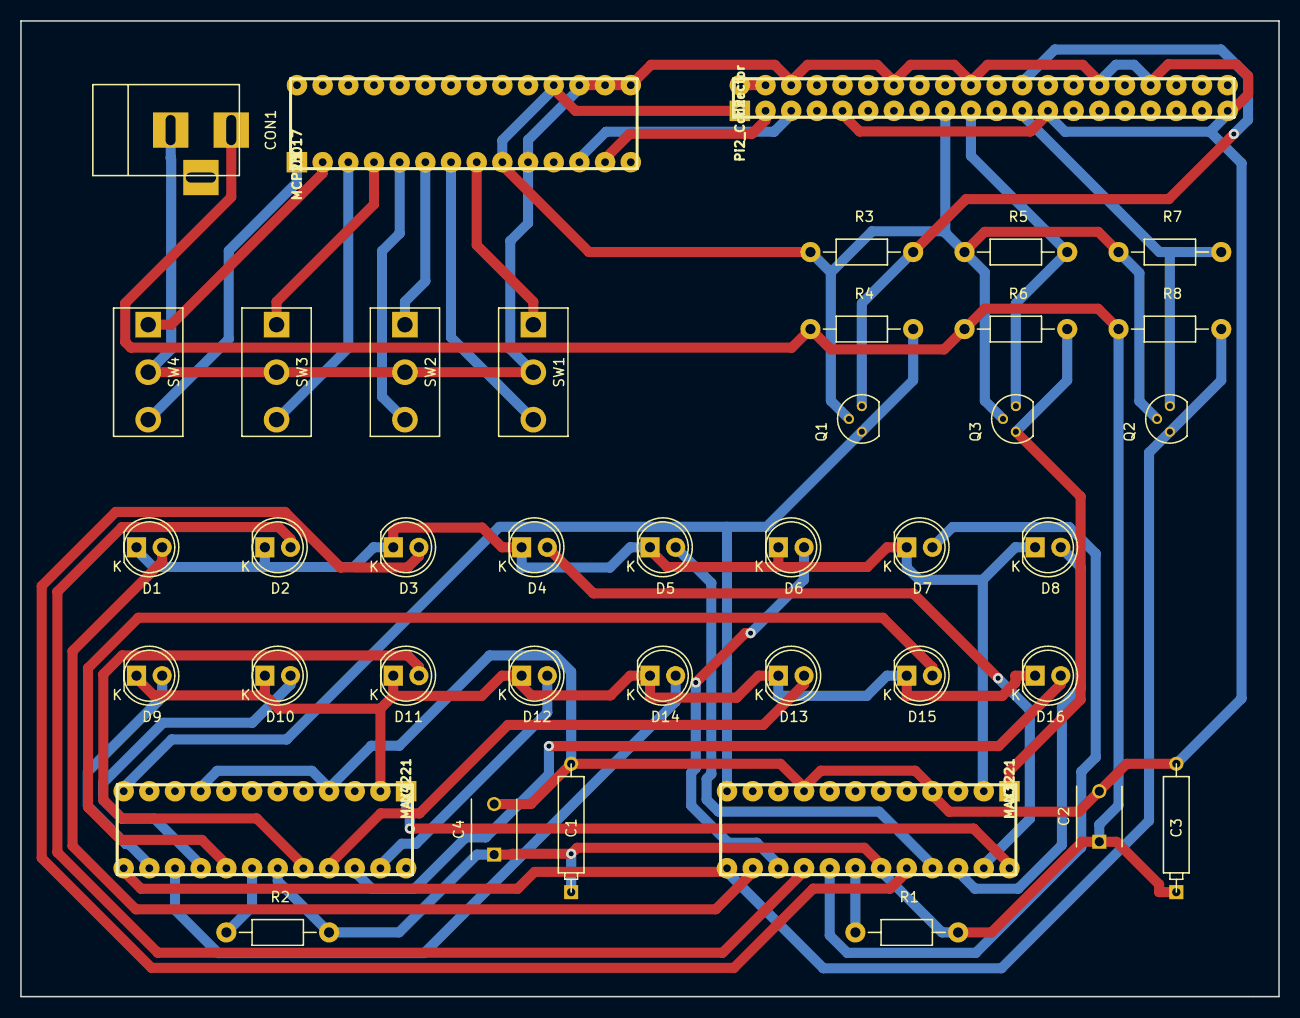
[picture p27: board prototype_pi_connect.kicad_pcb from above]

Board: 2 copper layers, 124.5 x 96.5 mm, 40 parts (0 on the bottom side), 41 nets.
