kristianhentschel/REDEUCE/hardware/prototype/trivial-double/trivial-double.kicad_pcb

## KiCad design hardware/prototype/trivial-double/trivial-double.kicad_pcb (2016-08-03)

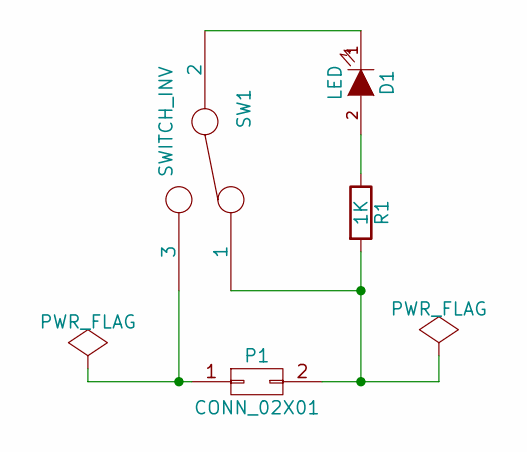
[picture p28: schematic trivial-double.sch]

Parts:
D1: LED; LED-5MM
P1: CONN_02X01; Pin_Header_Straight_2x01
R1: 1K; Resistor_Horizontal_RM10mm
SW1: SWITCH_INV; SW_SPDT

Connections:
unnamed: D1.1 (K), SW1.2
unnamed: D1.2 (A), R1.1
unnamed: P1.1, SW1.3
unnamed: P1.2, R1.2, SW1.1

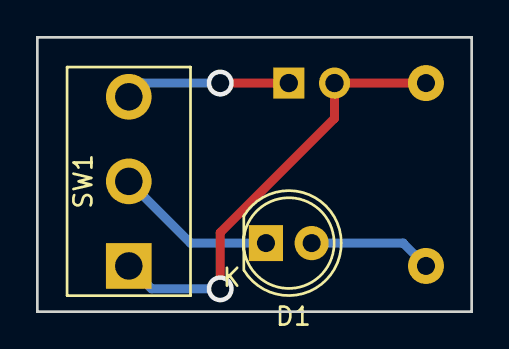
[picture p29: board trivial-double.kicad_pcb from above]

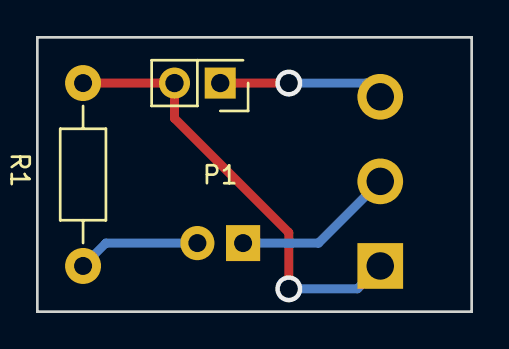
[picture p30: board trivial-double.kicad_pcb from below]

Board: 2 copper layers, 24.1 x 15.2 mm, 4 parts (2 on the bottom side), 4 nets.
