kristianhentschel/REDEUCE/hardware/prototype/trivial/trivial.kicad_pcb

## KiCad design hardware/prototype/trivial/trivial.kicad_pcb (2016-07-27)

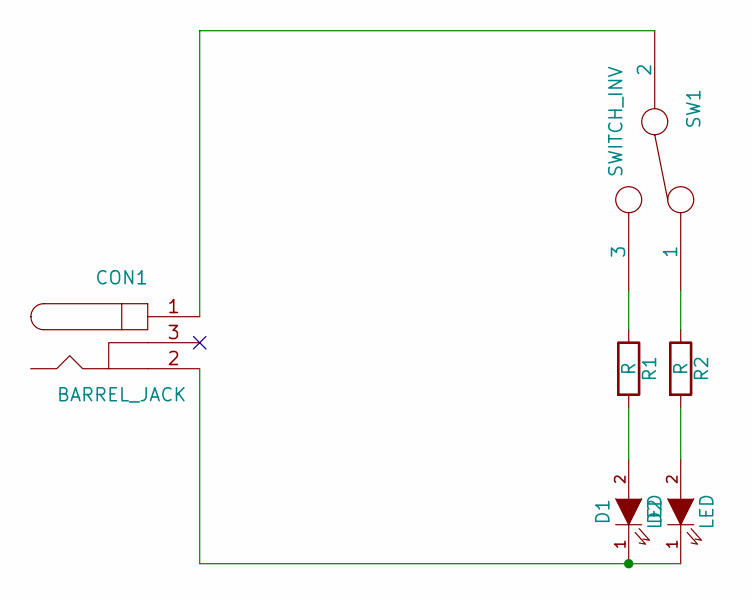
[picture p31: schematic trivial.sch]

Parts:
CON1: BARREL_JACK
D1, D2: LED; LED-5MM
R1, R2: R; Resistor_Horizontal_RM10mm
SW1: SWITCH_INV; SW_SPDT

Connections:
unnamed: CON1.1, SW1.2
unnamed: CON1.2, D1.1 (K), D2.1 (K)
unnamed: D1.2 (A), R1.2
unnamed: D2.2 (A), R2.2
unnamed: R1.1, SW1.3
unnamed: R2.1, SW1.1

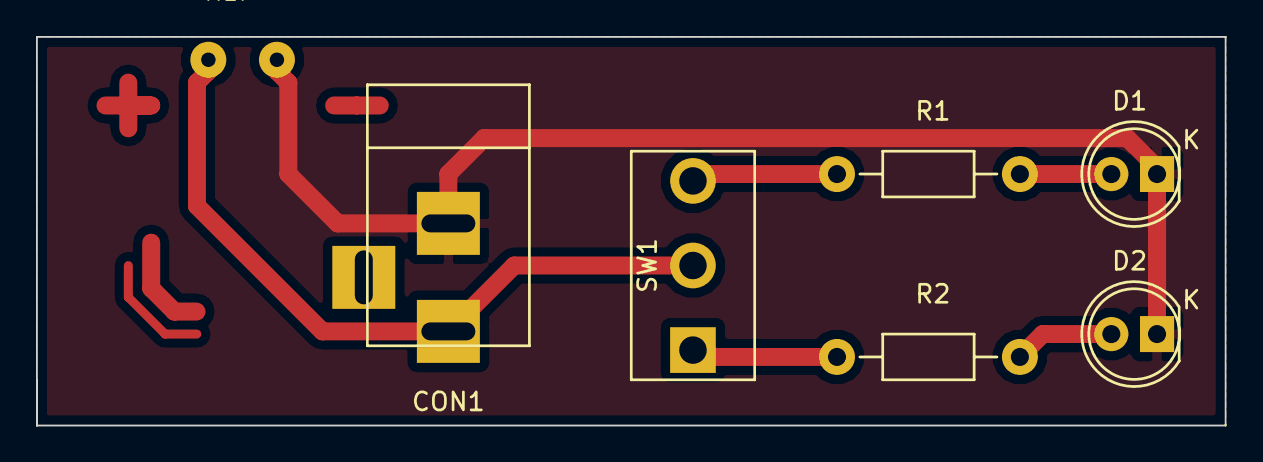
[picture p32: board trivial.kicad_pcb from above]

Board: 2 copper layers, 66.0 x 21.6 mm, 6 parts (0 on the bottom side), 6 nets.
