kristianhentschel/REDEUCE/(commit log)

2016-07-26 Add datasheets for prototype components for reference.
2016-07-26 add parts list ordered for the prototype board.
2016-07-26 Add KiCad schematic libraries and footprint modules for MAX7221 display driver, generated through http://kicad.rohrbacher.net/ .
2016-07-26 Add a prototype schematic for 64 LEDs and a MAX7221 driver. Using this to learn the PCB design software.
    [prototype.kicad_pcb, prototype.sch]
2016-07-26 Include the footprint modules, and assign footprints to all components.
    [prototype.sch]
2016-07-26 put components onto a board, still a mess.
    [prototype.kicad_pcb]
2016-07-27 Add libraries for IO expander and Raspberry Pi connector.
2016-07-27 Move prototype circuit schematic into subfolder as it only includes the LED matrix circuit.
    [prototype.dsn, prototype.kicad_pcb, prototype.sch]
2016-07-27 Add pi-connected prototype schematic, with 4 switches and 16 leds, to try out component fit and IC logic.
    [mosfet_level_shifter.sch, prototype_pi_connect.kicad_pcb, prototype_pi_connect.sch]
2016-07-27 Assign footprints
    [mosfet_level_shifter.sch, prototype_pi_connect.sch]
2016-07-27 Add footprint fot SPDT switches according to datasheet for 100SP4T1B1M2QEH. Also attempted to route some of this complex circuit manually.
    [mosfet_level_shifter.sch, prototype_pi_connect.sch]
2016-07-27 Add a trivial board just fr testing hte footprints and pcb plotting process.
    [_saved_trivial.sch, trivial.kicad_pcb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]
2016-07-27 Autoroute pi_connect project, add gerber and drill files plotted with default settings.
    [_saved_trivial.sch, prototype_pi_connect.dsn, prototype_pi_connect.kicad_pcb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]
2016-07-28 Add corrected Pi connector footprint and re-route the prototype board.
    [prototype_pi_connect.dsn, prototype_pi_connect.kicad_pcb]
2016-07-28 Add mosfet datasheet (for level shifter)
2016-07-28 Add testtraces project to be used for calibrating pcb plotter.
    [testtraces.kicad_pcb, testtraces.sch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]
2016-08-03 Add a trivial double sided board to test PCB machine.
    [trivial-double.kicad_pcb, trivial-double.sch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]
2016-08-03 Increased trace and via diameter size
    [trivial-double.kicad_pcb]
2016-08-03 Rerouted pi connect prototype for a slightly smaller board.
    [prototype_pi_connect.dsn, prototype_pi_connect.kicad_pcb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]
2016-08-04 Add plans for PCB layout and production.
2016-08-04 Add some basic elements for v1 pcbs, such as 16-led-rows and drivers.
    [lamps-16.sch, ledcontroller.sch, ledrow.sch, mosfet_level_shifter.sch, piconnect.sch, switchcontroller.sch, switchrow.sch, v1.kicad_pcb]
2016-08-04 Some autorouting on 16led row
    [_saved_lamps-16.sch, lamps-16.dsn, lamps-16.kicad_pcb, ledcontroller.sch, ledrow.sch, mosfet_level_shifter.sch, piconnect.sch, switchcontroller.sch]
2016-08-04 More routing experiments.
    [_saved_lamps-16.sch, lamps-16.dsn, lamps-16.kicad_pcb, ledrow.sch]
2016-08-05 Manually route lmaps-16 board
    [lamps-16.kicad_pcb, lamps-16.sch, ledrow.sch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]
2016-08-05 Correct lamps-16 connector layout in piconnect board.
    [lamps-16.sch, ledrow.sch, piconnect.sch]
2016-08-05 Start adding pi gpio port to piconnect board.
    [piconnect.sch]
2016-08-05 Route boards for lamps-13 and lamps-3a (one pcb file)
    [lamps-13_3a.kicad_pcb, lamps-13_3a.sch, lamps-16.sch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]
2016-08-05 Add switches-16 board and route it.
    [lamps-13_3a.sch, lamps-16.sch, ledcontroller.sch, ledrow.sch, mosfet_level_shifter.sch, piconnect.sch, switchcontroller.sch, switches-16.kicad_pcb]
2016-08-05 fix missing connections in switches-16
    [switches-16.kicad_pcb]
2016-08-05 generate gerber and drill file for switches-16.
    [switches-16-B.Cu.gbr, switches-16-Edge.Cuts.gbr, switches-16-F.Cu.gbr, switches-16.drl]
2016-08-05 Add keys-8 schematic and initial pcb layout file.
    [keys-8.kicad_pcb, keys-8.sch, lamps-13_3a.sch, lamps-16.sch, ledcontroller.sch, ledrow.sch, mosfet_level_shifter.sch, piconnect.sch]
2016-08-05 Route keys-8 and generate gerber files.
    [keys-8.kicad_pcb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]
2016-08-05 just moved things around a little bit
    [keys-8.kicad_pcb]
2016-08-06 Add rough layout of pcbs behind front panel.
    [lamps-13_3a-Edge.Cuts.gbr]
2016-08-07 Add custom footprints with fab layer for front panel drilling outlines.
2016-08-07 replace switch footprints on keys-8
    [keys-8.kicad_pcb, keys-8.sch]
2016-08-07 slightly re-route keys-8 to shave off a few mm. Re-export gerber files and svg (edge.cuts and b.fab) to put into a new front panel cutting file.
    [keys-8.kicad_pcb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]
2016-08-07 replace switch footprints in switches-16
    [switches-16.kicad_pcb, switches-16.sch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]
2016-08-07 Replace LED footprints in lamps-13_3a, and delete additional unneded gerber outputs.
    [lamps-13_3a.kicad_pcb, lamps-13_3a.sch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]
2016-08-07 Add new M3 drill mark pads to lamsp-13-3a
    [lamps-13_3a.kicad_pcb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]
2016-08-07 Add m3 holes and re-route around them for led boards.
    [lamps-13_3a.kicad_pcb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]
2016-08-07 Assign DP pin to led0 connection to match 8-bit values in MAX7221 register.
    [ledcontroller.sch, mosfet_level_shifter.sch, piconnect.sch]
2016-08-07 Align most front panel outlines/holes and add temporary labels.
2016-08-08 Add bill of materials, coming to approx 600 pounds so far.
    [v1_bom.xlsx]
2016-08-08 Change switch footprints, correcting the alignment pin placement
    [keys-8.kicad_pcb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]
2016-08-08 Add rotary switch doc, footprint, and basic circuit
    [delaylineselect.kicad_pcb, delaylineselect.sch, keys-8.sch, lamps-13_3a.sch, lamps-16.sch, ledcontroller.sch, ledrow.sch, mosfet_level_shifter.sch]
2016-08-08 Simplify routing for delaylineselect, generate gerber files and svg.
    [delaylineselect.kicad_pcb, delaylineselect.sch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]
2016-08-08 Add SVG control panel processed for laser cutting:
    - convert all text to paths
    - use red (cut) and blue (score) outlines of width 0.01mm
    - check all units are in mm and 5mm margin is kept to
2016-08-09 Re-arrange switch connector pinout to simpler single-row header. Re-route the switch boards accordingly.
    [delaylineselect.kicad_pcb, delaylineselect.sch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]
2016-08-09 Add mc slip, delay line select, and additional spare panels to laser cut panel file.
2016-08-09 Assigning most buttons. Still 5-6 I am very unsure about.
    [v1_bom.xlsx]
2016-08-10 Add list of new boards to be made
2016-08-10 Add new schematics for additional switch boards
    [_saved_keys-3-3.sch, delaylineselect.sch, keys-3-3.kicad_pcb, keys-3-3.sch, keys-6.kicad_pcb, keys-6.sch, keys-8.sch, keys-9.kicad_pcb]
2016-08-10 Integrate first set of switches
    [_saved_keys-3-3.sch, keys-3-3.kicad_pcb, keys-3-3.sch]
2016-08-10 Add keys-6 board and add to front panel drawing.
    [keys-3-3-B.Cu.gbr, keys-3-3-Edge.Cuts.gbr, keys-3-3-F.Cu.gbr, keys-3-3.drl, keys-6-B.Cu.gbr, keys-6-Edge.Cuts.gbr, keys-6-F.Cu.gbr, keys-6.drl]
2016-08-10 Add Keys-9
    [keys-9.sch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]
2016-08-10 SVG now has all boards placed and updated. added the last lamps.
    [delaylineselect.sch, keys-3-3.sch, keys-6.sch, keys-8.sch, keys-9.sch, lamps-13_3a.sch, lamps-16.sch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]
2016-08-11 Correct dial size (sources say 3 inch or 78mm - settled for 77 now), and reduce size of board for lights-4-3 (4 part).
    [lamps-4-3.kicad_pcb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]
2016-08-11 Add pcbs and cutouts for magnetic drum store status lamps (not labelled).
    [delaylineselect.sch, keys-3-3.sch, keys-6.sch, keys-8.sch, keys-9.sch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]
2016-08-11 Add processed files ready for laser cutting.
    [v1_bom.xlsx]
2016-08-11 Correct mistake on laser cutting file, add parts order list.
    [v1_bom.xlsx]
2016-08-12 Correct footprints for barrel connector and rotary switch.
    [delaylineselect.kicad_pcb, ledcontroller.sch, mosfet_level_shifter.sch, piconnect.sch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]
2016-08-12 Complete piconnect circuit and start routing.
    [ledcontroller.sch, mosfet_level_shifter.sch, piconnect.dsn, piconnect.kicad_pcb, piconnect.sch]
2016-08-12 Finish routing of piconnect board and generate gerber files
    [piconnect-B.Cu.gbr, piconnect-B.Fab.gbr, piconnect-B.Mask.gbr, piconnect-B.SilkS.gbr, piconnect-Edge.Cuts.gbr, piconnect-F.Cu.gbr, piconnect-F.Fab.gbr, piconnect-F.Mask.gbr]
2016-08-12 Add gerber files for all boards to be potentially made by ragworm.
    [keys-8-B.Cu.gbr, keys-8-B.Fab.gbr, keys-8-B.Mask.gbr, keys-8-B.SilkS.gbr, keys-8-Edge.Cuts.gbr, keys-8-F.Cu.gbr, keys-8-F.Fab.gbr, keys-8-F.Mask.gbr]
2016-08-12 Generate additional gerber files for switches-16.
    [switches-16-B.Cu.gbr, switches-16-B.Fab.gbr, switches-16-B.Mask.gbr, switches-16-B.SilkS.gbr, switches-16-Edge.Cuts.gbr, switches-16-F.Fab.gbr, switches-16-F.Mask.gbr, switches-16-F.SilkS.gbr]
2016-08-13 Add mosfet clock gates to I2C connector rows - because addresses conflict and the second bus (I2C0) cannot be used safely on the raspberry pi.
    [ledcontroller.sch, mosfet_level_shifter.sch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]
2016-08-29 Export all switches v1.1 gerber files again because silkscreen and mask were missing.
    [switches-16-B.Cu.gbr, switches-16-B.Fab.gbr, switches-16-B.Mask.gbr, switches-16-B.SilkS.gbr, switches-16-Edge.Cuts.gbr, switches-16-F.Cu.gbr, switches-16-F.Fab.gbr, switches-16-F.Mask.gbr]
2016-08-29 Make rotary switch footprint use circular holes for compatibility with PCB machine software.
    [delaylineselect.kicad_pcb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]
2016-08-29 correct last oval hole in delaylineselect
    [delaylineselect.kicad_pcb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]
2016-08-31 start writing switches demo
2016-08-31 add driversandbox board for software testing of piconnect board.
    [driversandbox.kicad_pcb, driversandbox.sch, ledcontroller.sch, mosfet_level_shifter.sch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]
2016-08-31 add more to switches script - still untested.
2016-09-01 Switches working with two devices on different channels on breadboard with pi1 (may need enable pin numbers changed!)
2016-09-01 lamps demo script working on pi1 with one digit, one device on breadboard.
2016-09-01 Add printer example
2016-09-01 Add notes and cost spreadsheet
    [deuce-parts-costs.xlsx]
2016-09-01 Add additional datasheets for printer and HDMI screen
2016-09-01 reformatted the piconnect board for printing
    [ledcontroller.sch, mosfet_level_shifter.sch, piconnect.sch]
2016-09-02 Add a PDF document with exported PCBs for identification and assembly instructions
    [delaylineselect.kicad_pcb, keys-3-3.kicad_pcb, keys-6.kicad_pcb, keys-8.kicad_pcb, keys-9.kicad_pcb, lamps-12-mag.kicad_pcb, lamps-13_3a.kicad_pcb, lamps-16-mag.kicad_pcb]
2017-03-04 test program in DEUCE assembler
2017-03-04 DEUCE assembler
